kglnsk/amp-power-whitepaper/media/results/photo_electronics.png

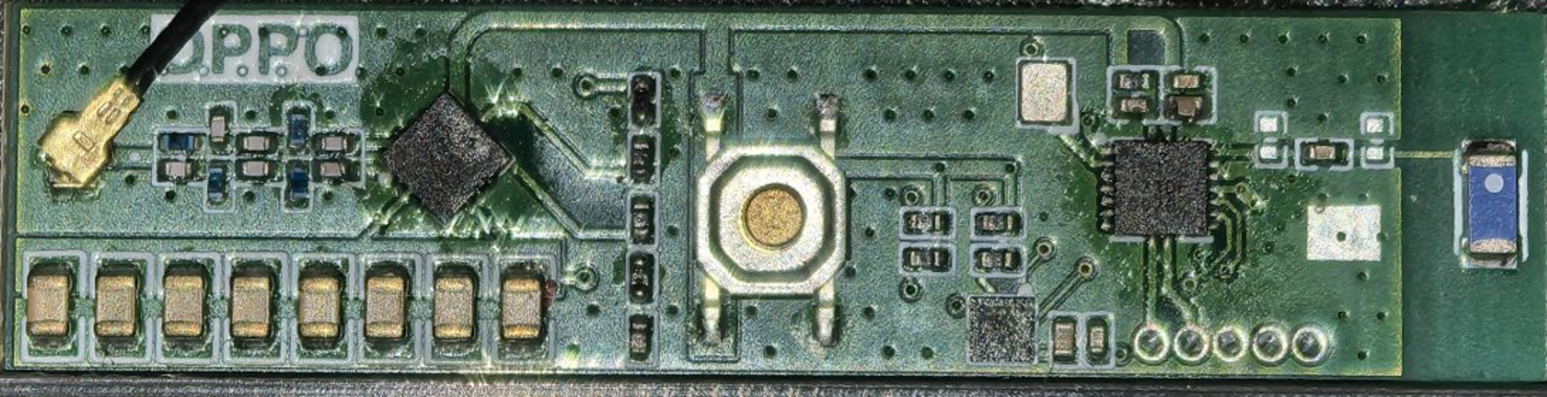
media/results/photo_electronics.png
