kglnsk/amp-power-whitepaper/media/sources/antenna_component_dimensions.png

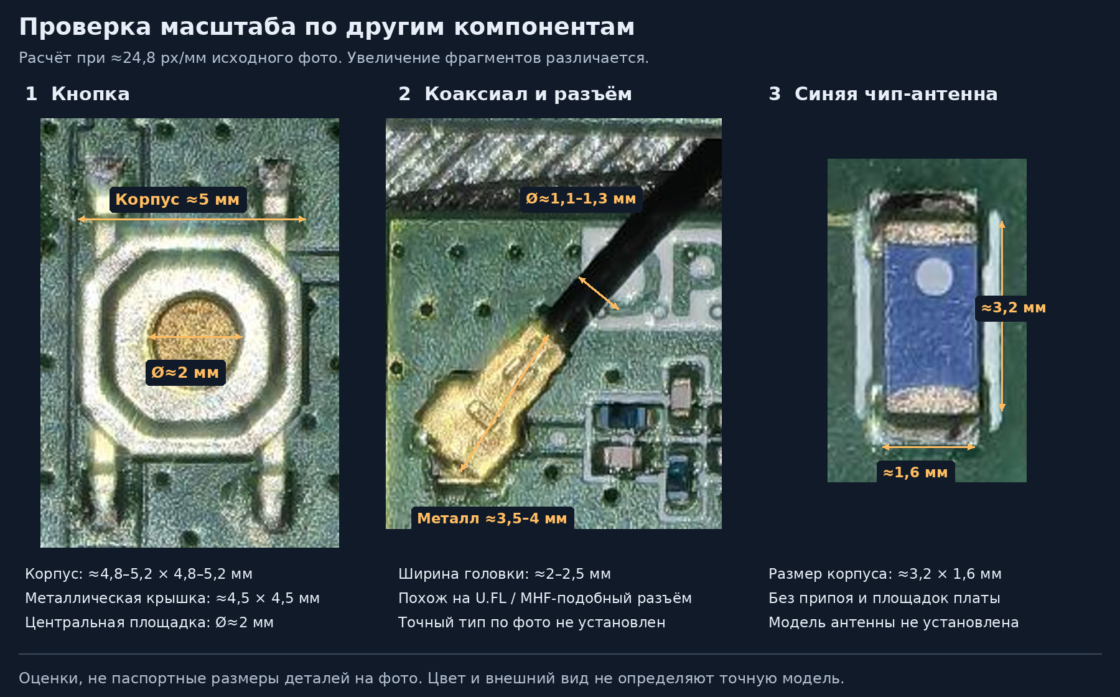
media/sources/antenna_component_dimensions.png
