kglnsk/amp-power-whitepaper/media/results/electronics_868_poster.png

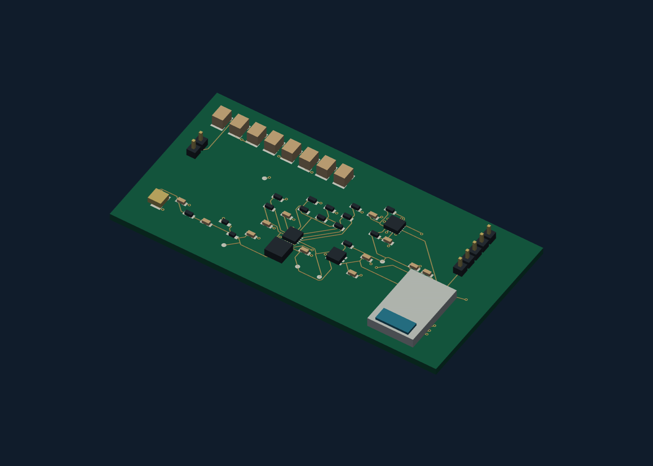
media/results/electronics_868_poster.png
