kglnsk/amp-power-whitepaper/downloads/results/budget.csv

scenario | band_MHz | eirp_dBm | distance_m | rf_duty | receive_gain_dBi | other_losses_dB | rf_on_dBm | pdc_on_model_uW | storage_average_uW | net_idle_uW | cold_start_power_only | feature_cycle_s | raw_cycle_s | raw_paced_cycle_s | clamped_above_simulation
WiFi idle | 2450 | 20 | 0.5 | 0.02 | 3 | 6 | -17.210504995894397 | 4.112073038303948 | 0.04029831577537869 | -2.4597016842246213 | False |  |  |  | False
WiFi idle | 2450 | 20 | 1 | 0.02 | 3 | 6 | -23.23110490917403 | 0.23232196889256107 | 0.0022767552951470987 | -2.4977232447048534 | False |  |  |  | False
WiFi idle | 2450 | 20 | 3 | 0.02 | 3 | 6 | -32.773530003567274 | 0.0 | 0.0 | -2.5 | False |  |  |  | False
WiFi idle | 2450 | 20 | 5 | 0.02 | 3 | 6 | -37.210504995894404 | 0.0 | 0.0 | -2.5 | False |  |  |  | False
WiFi busy | 2450 | 20 | 0.5 | 0.5 | 3 | 6 | -17.210504995894397 | 4.112073038303948 | 1.0074578943844672 | -1.492542105615533 | False |  |  |  | False
WiFi busy | 2450 | 20 | 1 | 0.5 | 3 | 6 | -23.23110490917403 | 0.23232196889256107 | 0.056918882378677454 | -2.4430811176213227 | False |  |  |  | False
WiFi busy | 2450 | 20 | 3 | 0.5 | 3 | 6 | -32.773530003567274 | 0.0 | 0.0 | -2.5 | False |  |  |  | False
WiFi busy | 2450 | 20 | 5 | 0.5 | 3 | 6 | -37.210504995894404 | 0.0 | 0.0 | -2.5 | False |  |  |  | False
WPT 2.45GHz 1W EIRP | 2450 | 30 | 0.5 | 0.9 | 3 | 6 | -7.2105049958943965 | 74.47782285282939 | 32.844719878097756 | 30.34471987809776 | True | 30.318289432094524 | 197.72797455713823 | 281.0999645002004 | False
WPT 2.45GHz 1W EIRP | 2450 | 30 | 1 | 0.9 | 3 | 6 | -13.231104909174029 | 13.448290278307708 | 5.930696012733699 | 3.4306960127336983 | False | 268.1671580883996 | 1748.9162484026065 |  | False
WPT 2.45GHz 1W EIRP | 2450 | 30 | 3 | 0.9 | 3 | 6 | -22.773530003567274 | 0.29241863801540374 | 0.12895661936479302 | -2.371043380635207 | False |  |  |  | False
WPT 2.45GHz 1W EIRP | 2450 | 30 | 5 | 0.9 | 3 | 6 | -27.210504995894404 | 0.0 | 0.0 | -2.5 | False |  |  |  | False
WPT 2.45GHz 4W EIRP | 2450 | 36 | 0.5 | 0.9 | 3 | 6 | -1.2105049958943965 | 133.57811999999998 | 58.90795091999999 | 56.40795091999999 | True | 20 | 106.36798362892918 | 126.56104901316839 | True
WPT 2.45GHz 4W EIRP | 2450 | 36 | 1 | 0.9 | 3 | 6 | -7.231104909174029 | 74.06924994081689 | 32.66453922390024 | 30.164539223900242 | True | 30.499388476355612 | 198.9090552805801 | 283.4930605635131 | False
WPT 2.45GHz 4W EIRP | 2450 | 36 | 3 | 0.9 | 3 | 6 | -16.773530003567274 | 4.653360054478848 | 2.052131784025172 | -0.4478682159748282 | False |  |  |  | False
WPT 2.45GHz 4W EIRP | 2450 | 36 | 5 | 0.9 | 3 | 6 | -21.210504995894404 | 0.497702178624538 | 0.21948666077342124 | -2.280513339226579 | False |  |  |  | False
WPT 915MHz FR4 | 915 | 30 | 0.5 | 0.9 | -1 | 6 | -2.6556051899327144 | 95.8626 | 42.27540659999999 | 39.77540659999999 | True | 23.12987040590052 | 150.84698090804687 | 194.96086852675415 | True
WPT 915MHz FR4 | 915 | 30 | 1 | 0.9 | -1 | 6 | -8.67620510321234 | 36.54908170906976 | 16.11814503369976 | 13.618145033699761 | False | 67.55692480314666 | 440.5886400205217 | 1299.2229469227354 | False
WPT 915MHz FR4 | 915 | 30 | 3 | 0.9 | -1 | 6 | -18.21863019760559 | 2.525552006077879 | 1.1137684346803445 | -1.3862315653196555 | False |  |  |  | False
WPT 915MHz FR4 | 915 | 30 | 5 | 0.9 | -1 | 6 | -22.655605189932714 | 0.38156455614679213 | 0.1682699692607353 | -2.3317300307392648 | False |  |  |  | False
