kglnsk/amp-power-whitepaper/media/results/assembly_3d.png

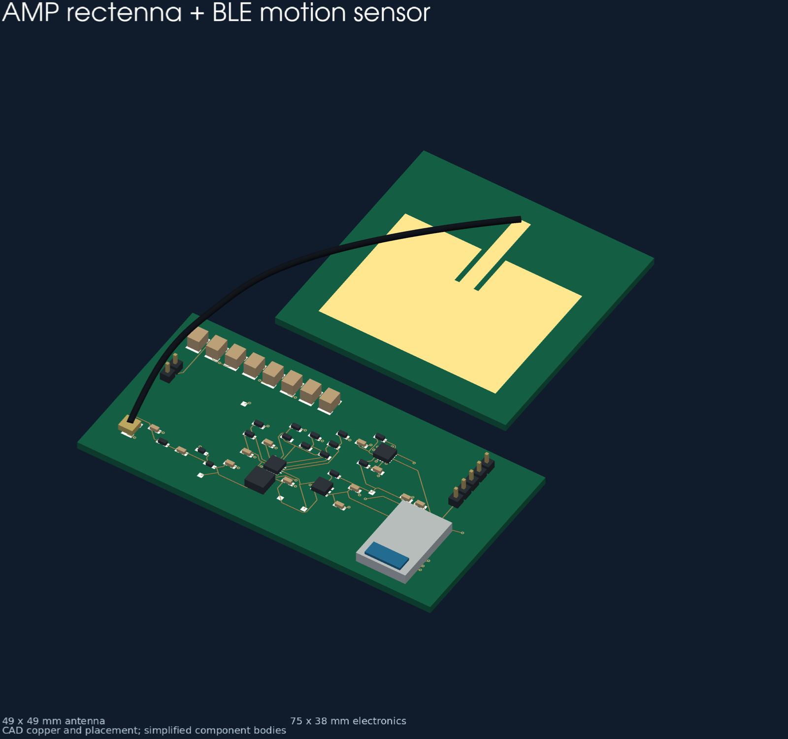
media/results/assembly_3d.png
