kglnsk/amp-power-whitepaper/media/results/assembly_868_poster.png

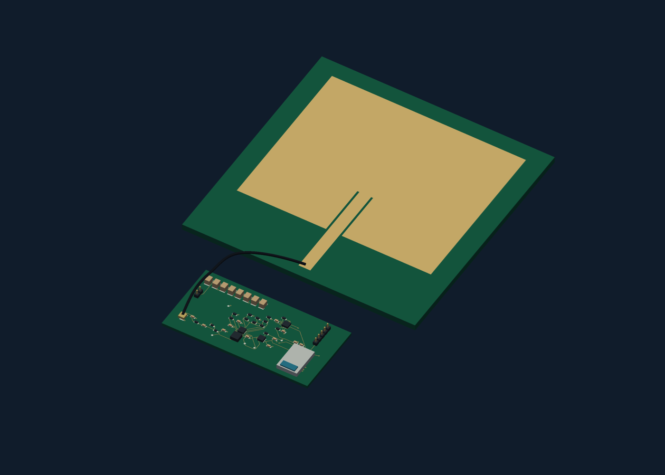
media/results/assembly_868_poster.png
