kglnsk/amp-power-whitepaper/media/results/assembly_top.png

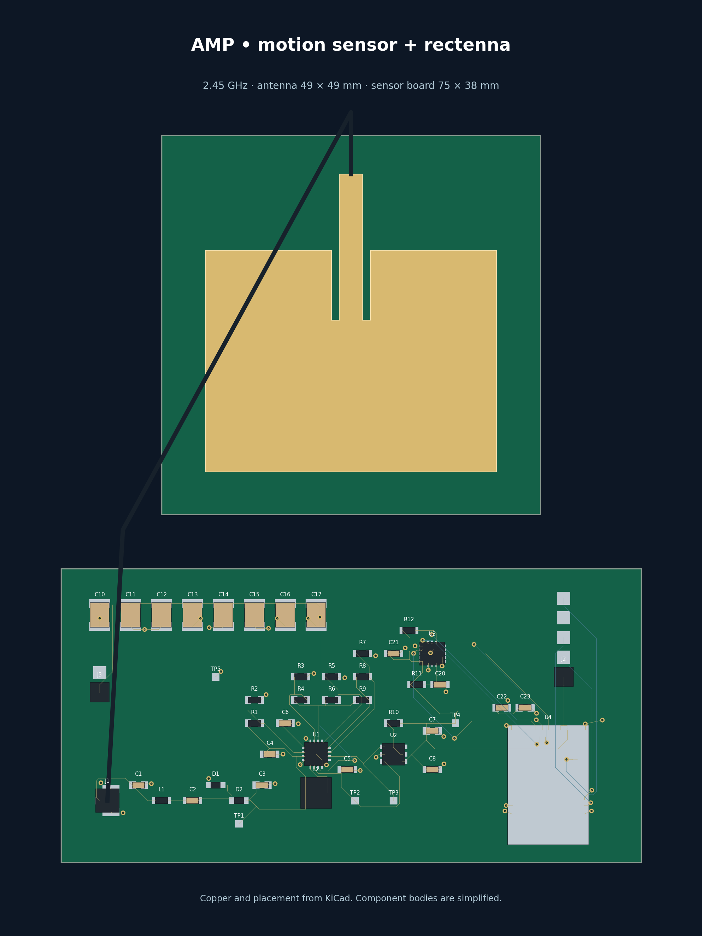
media/results/assembly_top.png
