kglnsk/amp-power-whitepaper/downloads/results/budget_868.csv

antenna_case | gain_dBi | extra_polarization_loss_dB | other_loss_dB | eirp_dBm | duty | distance_m | rf_on_dBm | stored_uW | net_uW | feature_cycle_s | cold_power_screen | curve_clamped
Taoglas reference 70mm ground | 2.17 | 0 | 6 | 20 | 0.9 | 0.5 | -9.027577812133586 | 12.7729226552175 | 10.2729226552175 | 89.55581881391296 | False | False
Taoglas reference 70mm ground | 2.17 | 0 | 6 | 20 | 0.9 | 1 | -15.048177725413211 | 2.1208913112400527 | -0.37910868875994747 |  | False | False
Taoglas reference 70mm ground | 2.17 | 0 | 6 | 20 | 0.9 | 3 | -24.590602819806456 | 0.014532594227435958 | -2.4854674057725643 |  | False | False
Taoglas reference 70mm ground | 2.17 | 0 | 6 | 30 | 0.9 | 0.5 | 0.9724221878664139 | 39.79999421999999 | 37.299994219999995 | 24.664883178633378 | True | True
Taoglas reference 70mm ground | 2.17 | 0 | 6 | 30 | 0.9 | 1 | -5.048177725413211 | 39.26879357934815 | 36.76879357934815 | 25.02121800691156 | True | False
Taoglas reference 70mm ground | 2.17 | 0 | 6 | 30 | 0.9 | 3 | -14.590602819806456 | 2.598120914794909 | 0.09812091479490888 | 9376.186533961414 | False | False
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
