kglnsk/amp-power-whitepaper/downloads/results/budget_fr4_868.csv

mode | gain_dBi | distance_m | eirp_dBm | duty | other_loss_dB | rf_on_dBm | stored_uW | net_uW | feature_cycle_s | raw_paced_cycle_s | cold_power_screen | curve_clamped
free | 1.6083529268196894 | 0.5 | 20 | 0.02 | 6 | -9.589224885313897 | 0.23181377307584564 | -2.2681862269241546 |  |  | False | False
free | 1.6083529268196894 | 0.5 | 20 | 0.5 | 6 | -9.589224885313897 | 5.79534432689614 | 3.2953443268961404 | 279.1817512030802 |  | False | False
free | 1.6083529268196894 | 0.5 | 20 | 0.9 | 6 | -9.589224885313897 | 10.431619788413053 | 7.9316197884130535 | 115.99143990033241 |  | False | False
free | 1.6083529268196894 | 1 | 20 | 0.02 | 6 | -15.609824798593522 | 0.04223257789333621 | -2.457767422106664 |  |  | False | False
free | 1.6083529268196894 | 1 | 20 | 0.5 | 6 | -15.609824798593522 | 1.0558144473334055 | -1.4441855526665948 |  |  | False | False
free | 1.6083529268196894 | 1 | 20 | 0.9 | 6 | -15.609824798593522 | 1.9004660052001299 | -0.5995339947998704 |  |  | False | False
free | 1.6083529268196894 | 3 | 20 | 0.02 | 6 | -25.152249892986767 | 0.0 | -2.5 |  |  | False | False
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
