kglnsk/amp-power-whitepaper/media/results/antenna_868_pattern.png

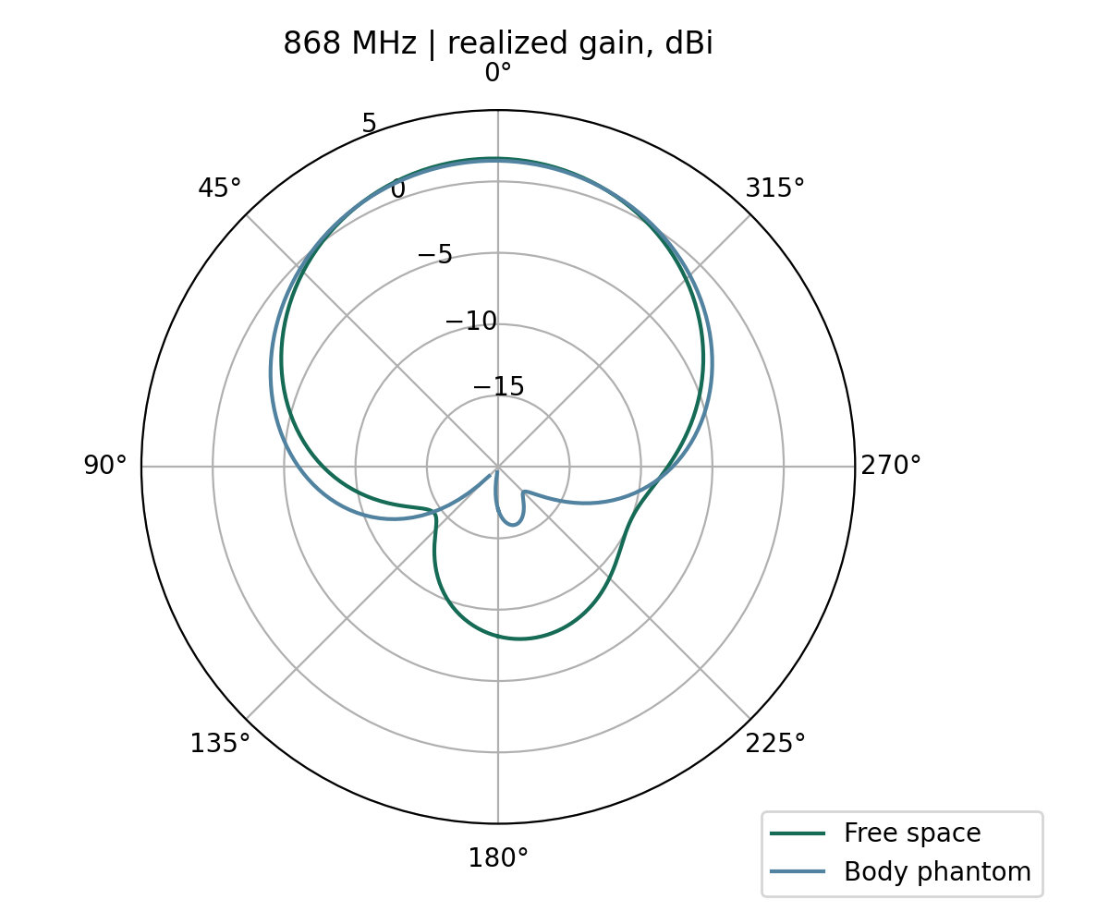
media/results/antenna_868_pattern.png
