kglnsk/amp-power-whitepaper/media/results/antenna_comparison.png

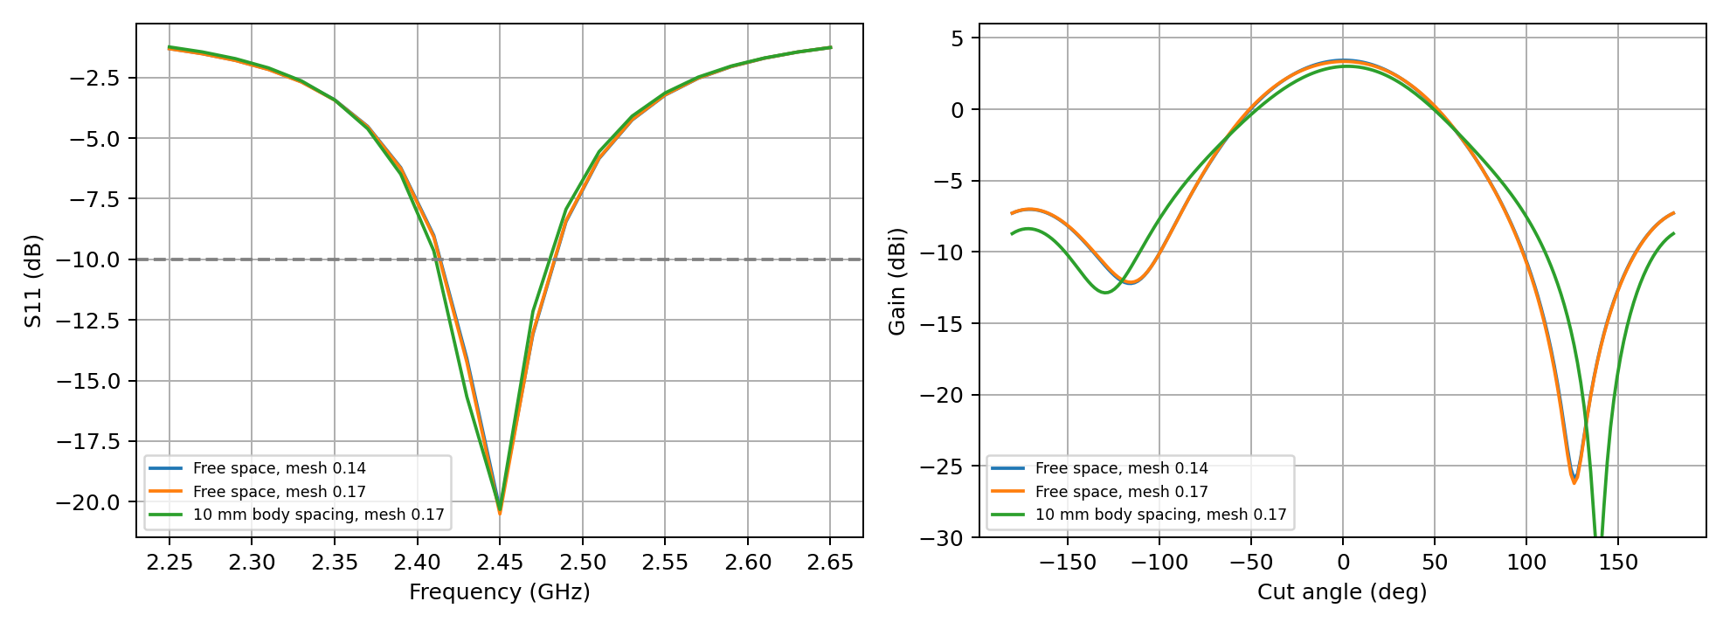
media/results/antenna_comparison.png
