kglnsk/amp-power-whitepaper/media/results/compact.png

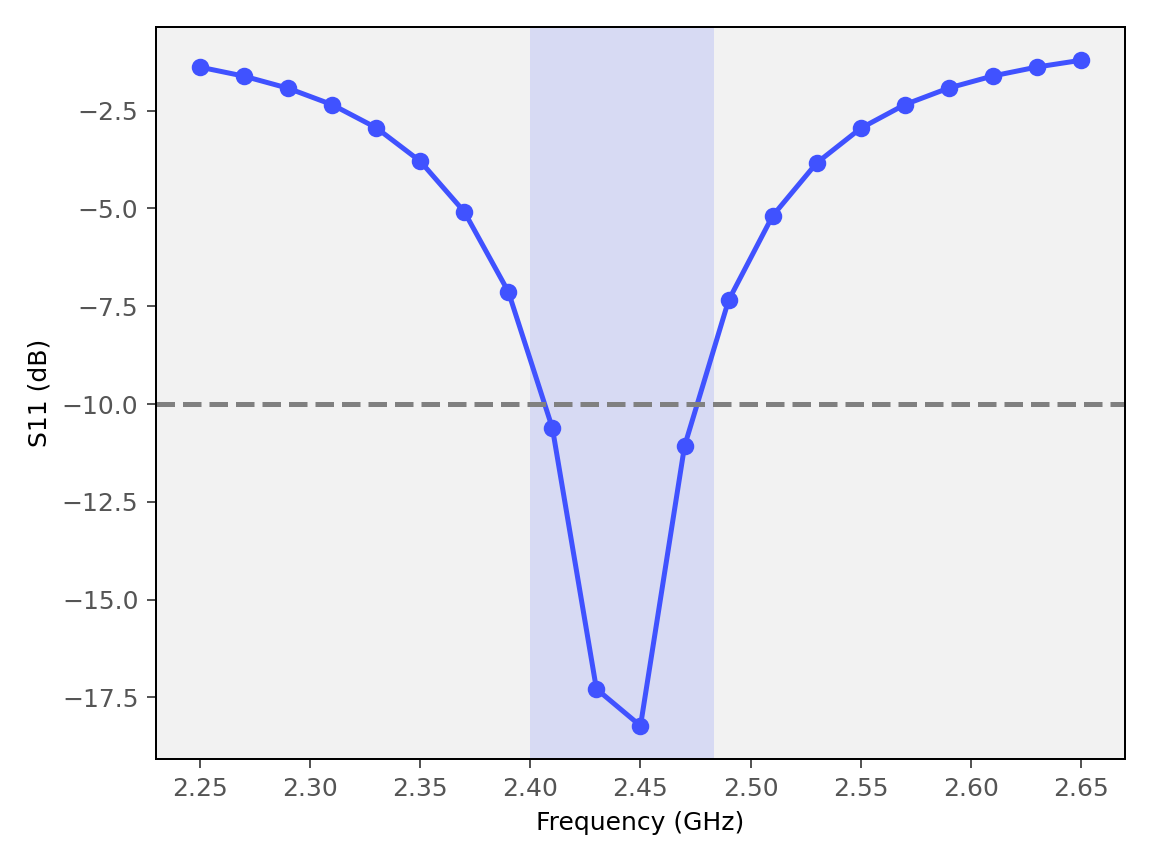
media/results/compact.png
