kglnsk/amp-power-whitepaper/media/results/energy_budget.png

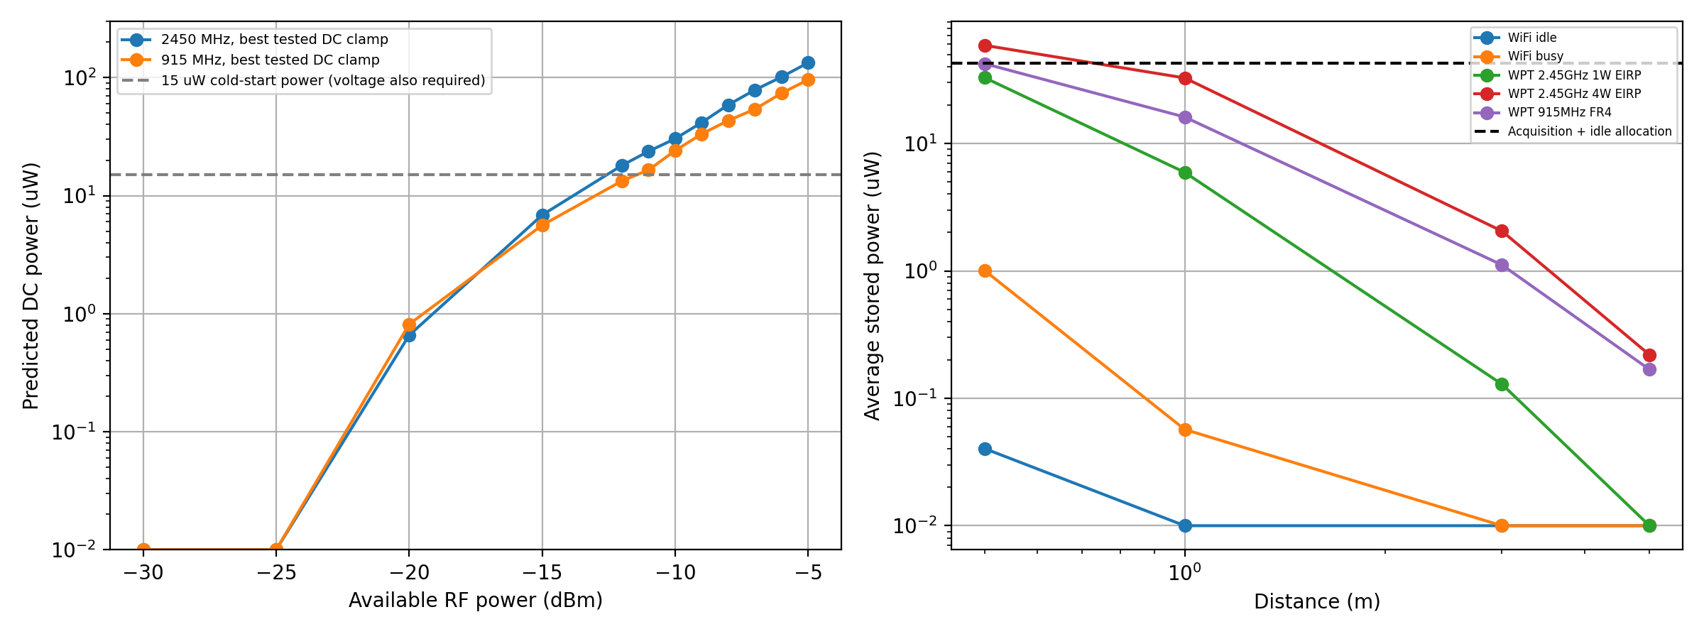
media/results/energy_budget.png
