kglnsk/amp-power-whitepaper/media/results/fr4_868_body.png

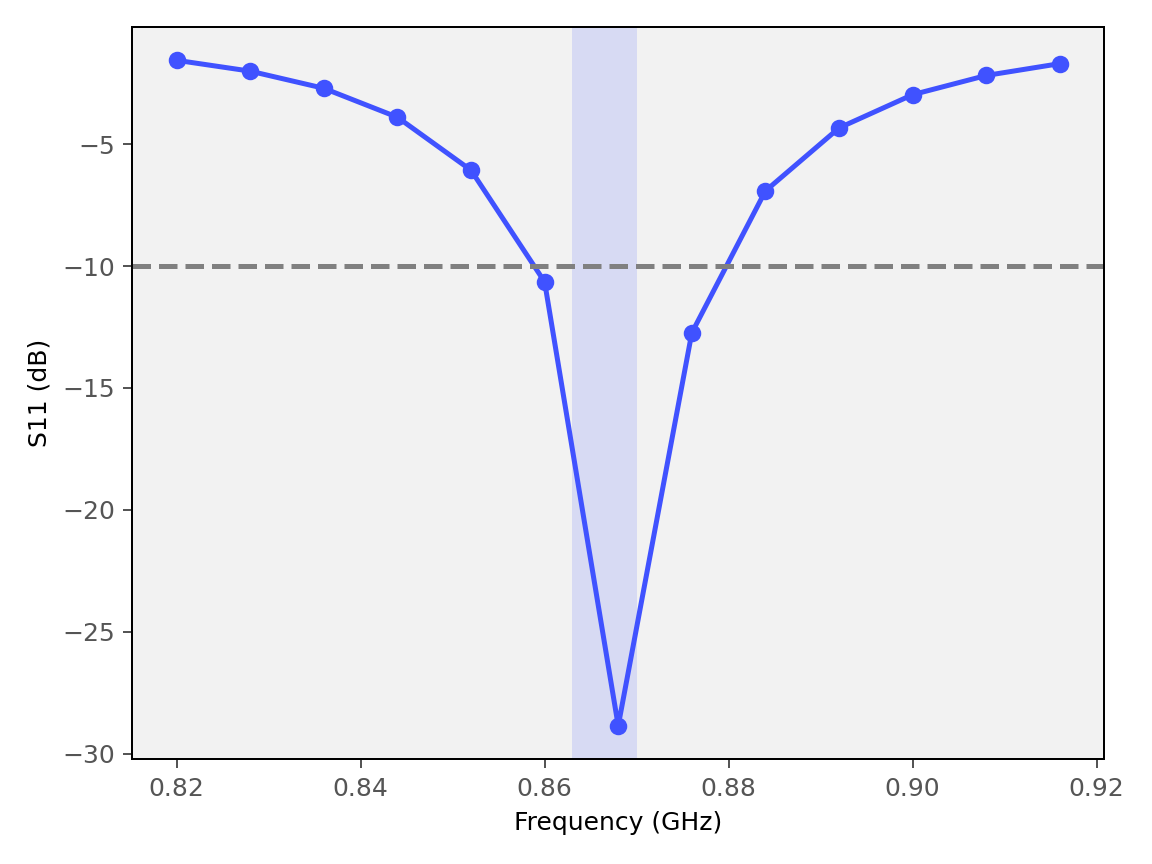
media/results/fr4_868_body.png
