kglnsk/amp-power-whitepaper/media/results/fr4_868_final.png

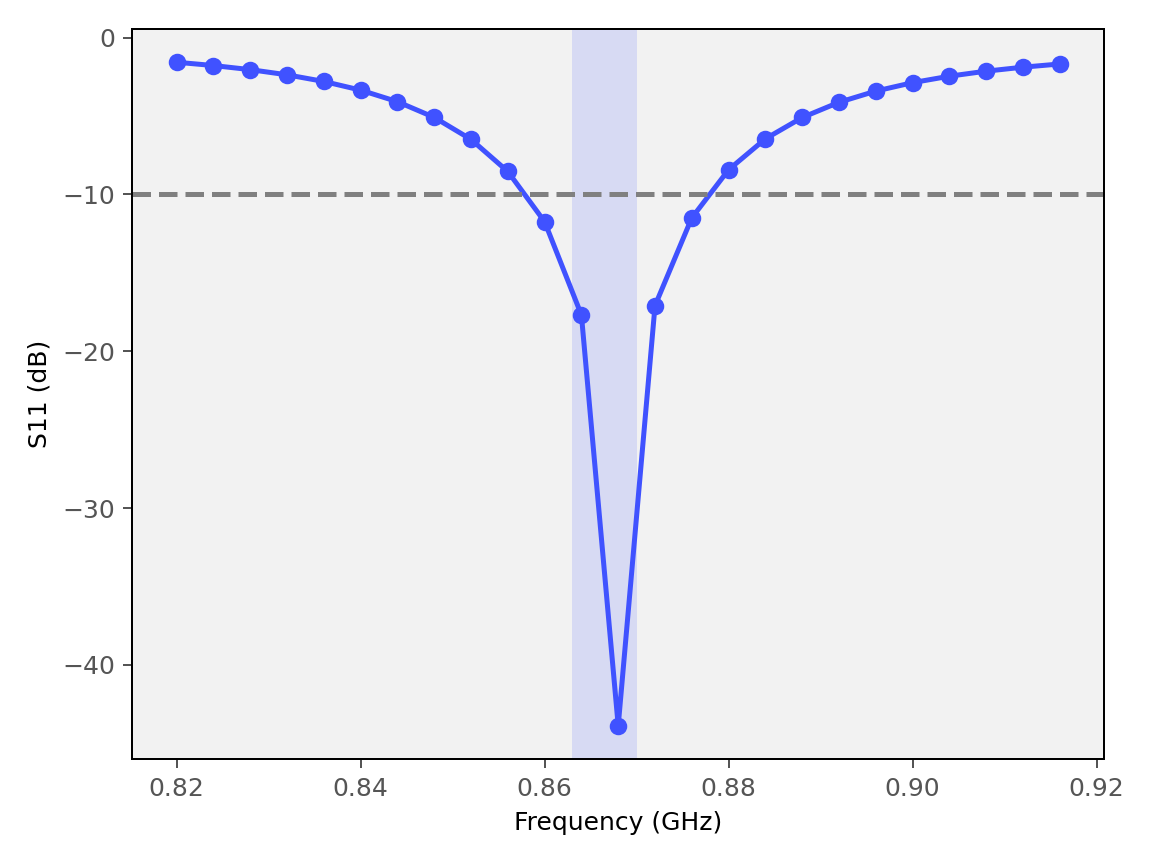
media/results/fr4_868_final.png
