kglnsk/amp-power-whitepaper/media/results/fr4_868_initial.png

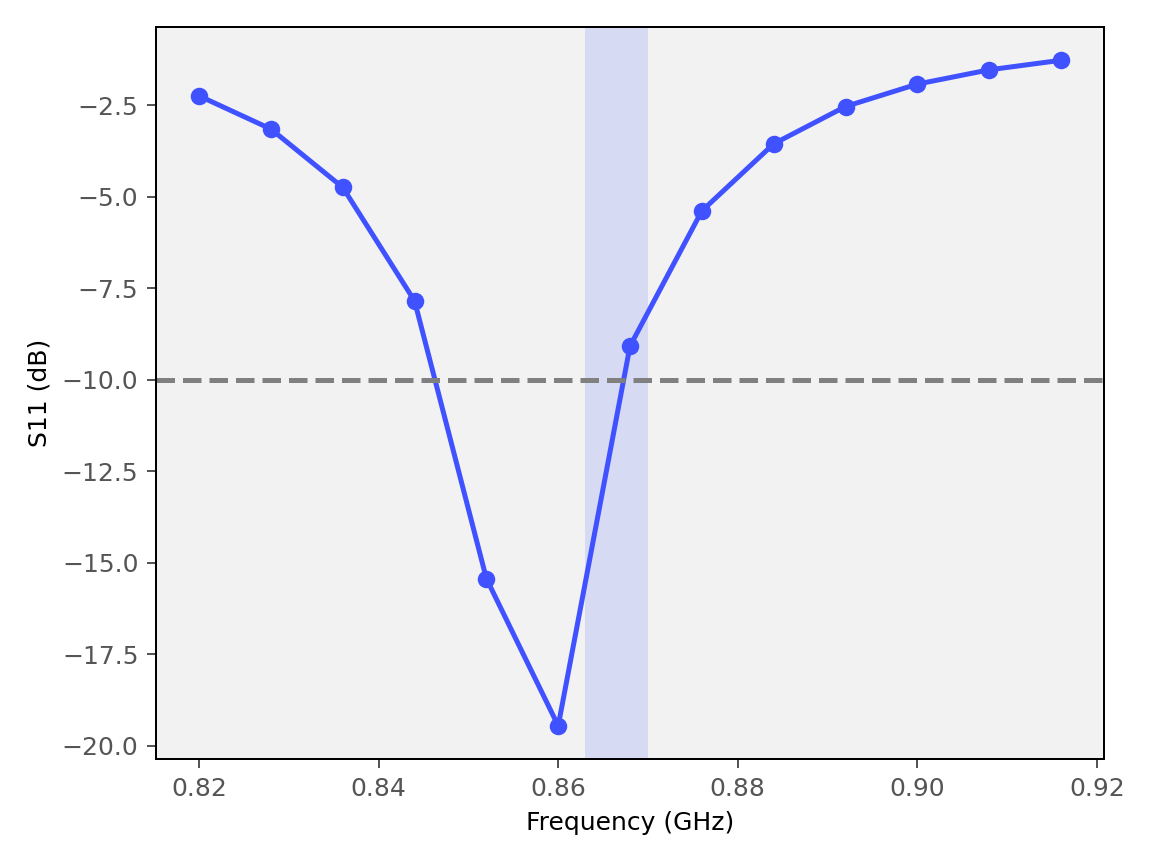
media/results/fr4_868_initial.png
