kglnsk/amp-power-whitepaper/media/results/initial.png

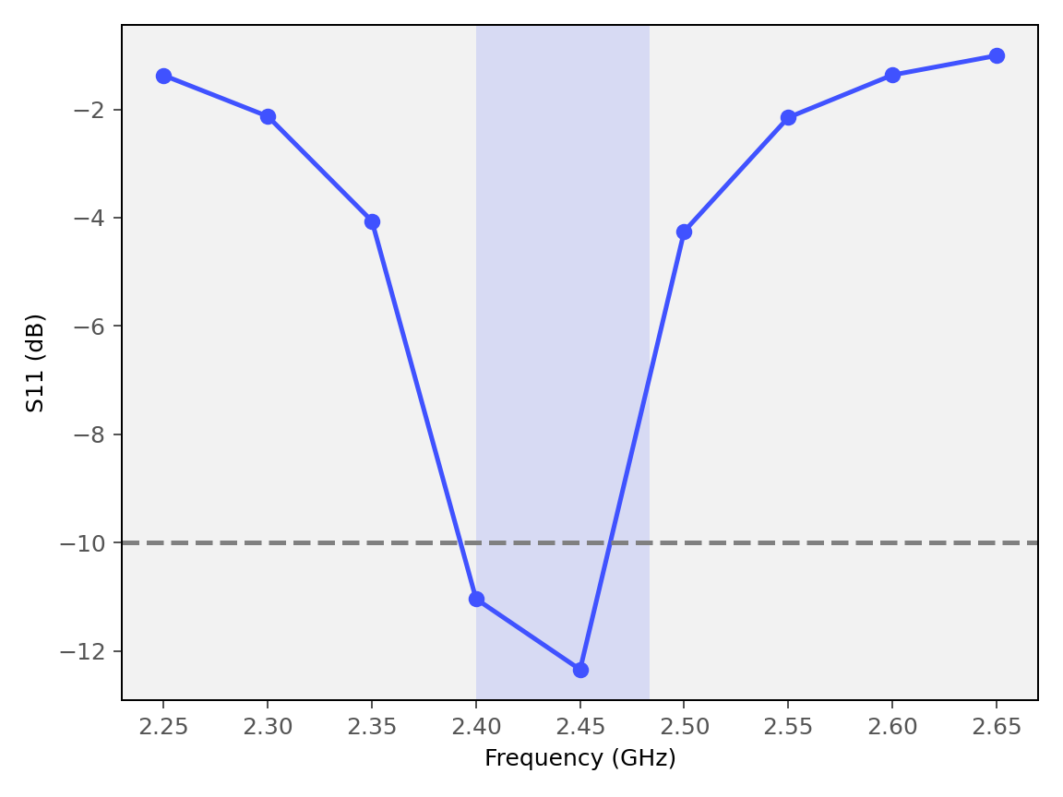
media/results/initial.png
