kglnsk/amp-power-whitepaper/media/results/pcb_combined.png

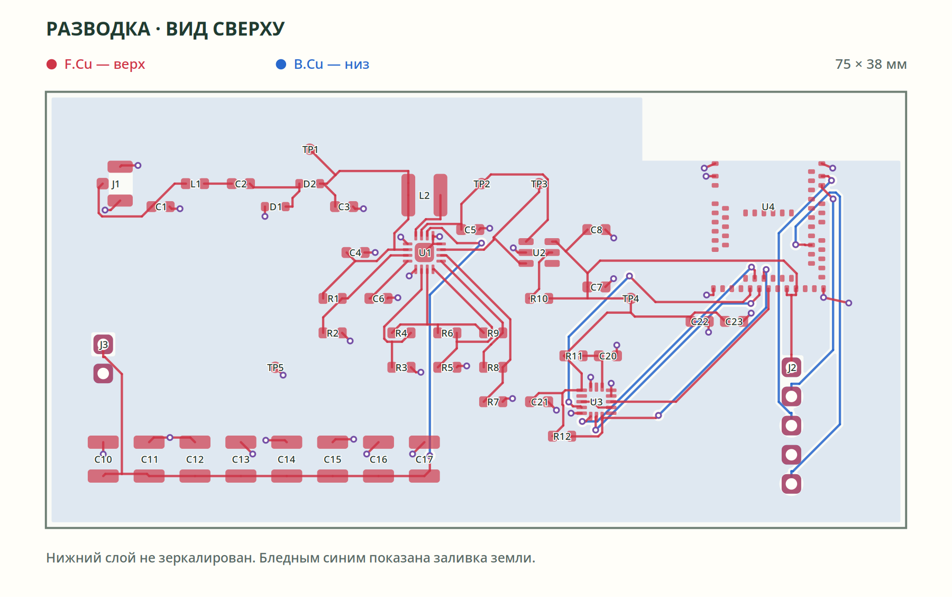
media/results/pcb_combined.png
