kglnsk/amp-power-whitepaper/media/results/uhf_initial.png

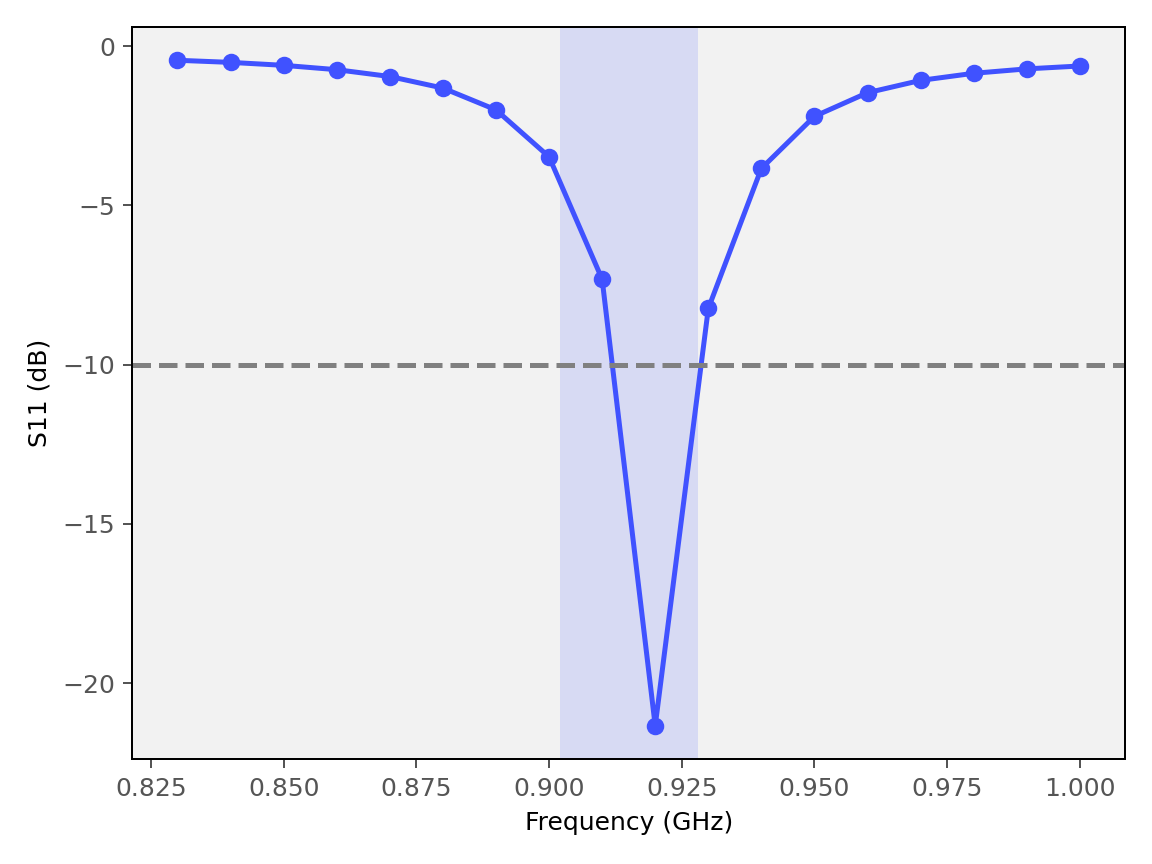
media/results/uhf_initial.png
