kglnsk/amp-power-whitepaper/downloads/hardware/amp_sensor.pdf

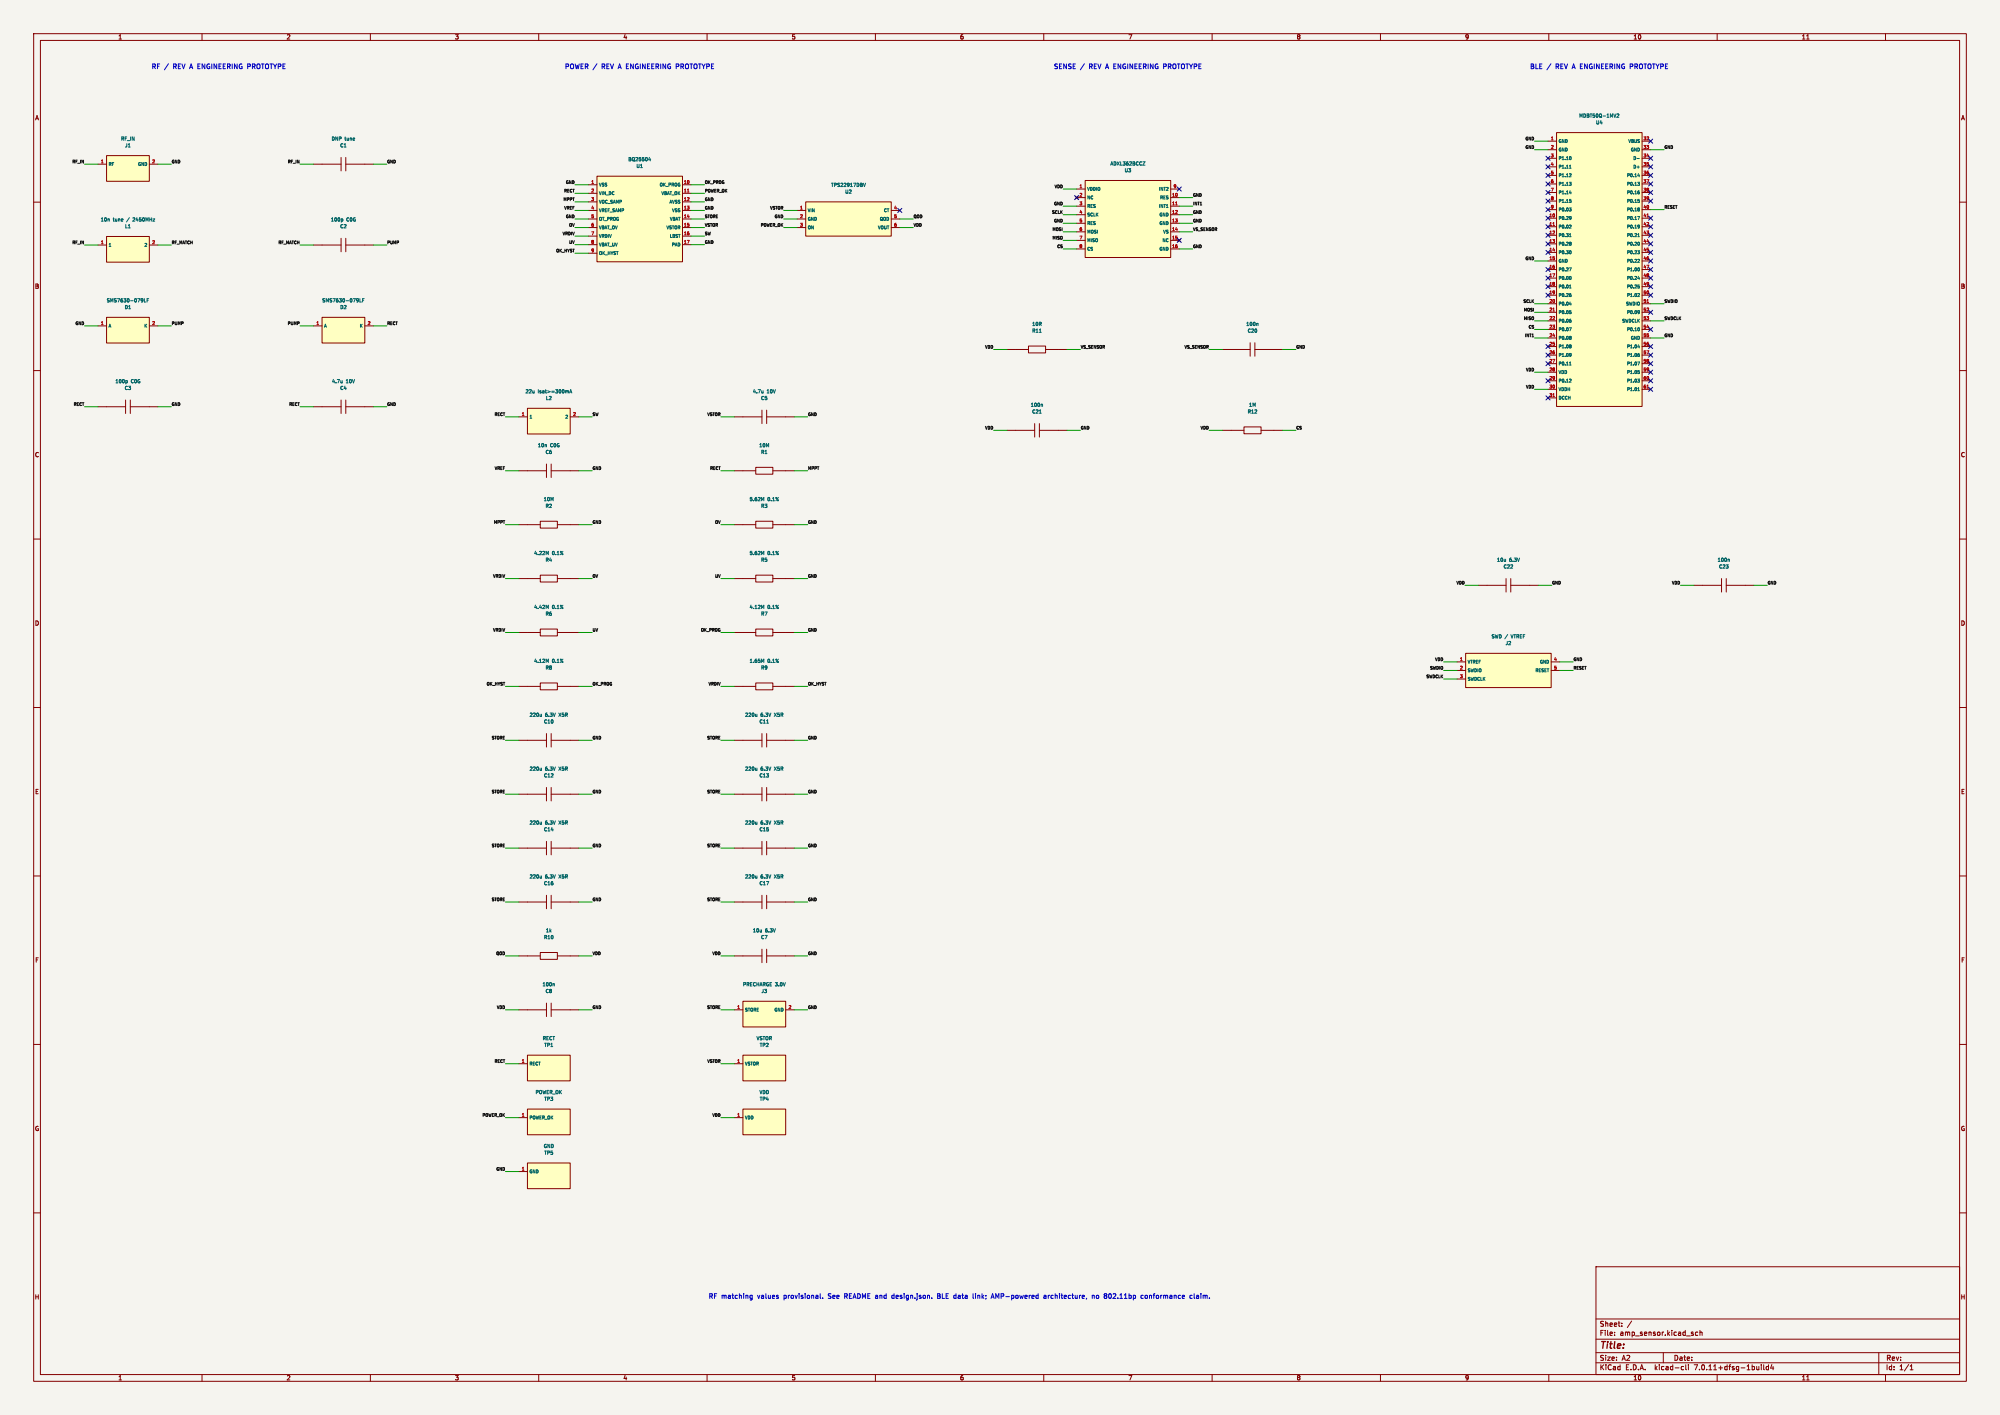
[picture p27: page 1]

POWER / REV A ENGINEERING PROTOTYPE
