kglnsk/amp-power-whitepaper/downloads/hardware/868/amp_sensor.pdf

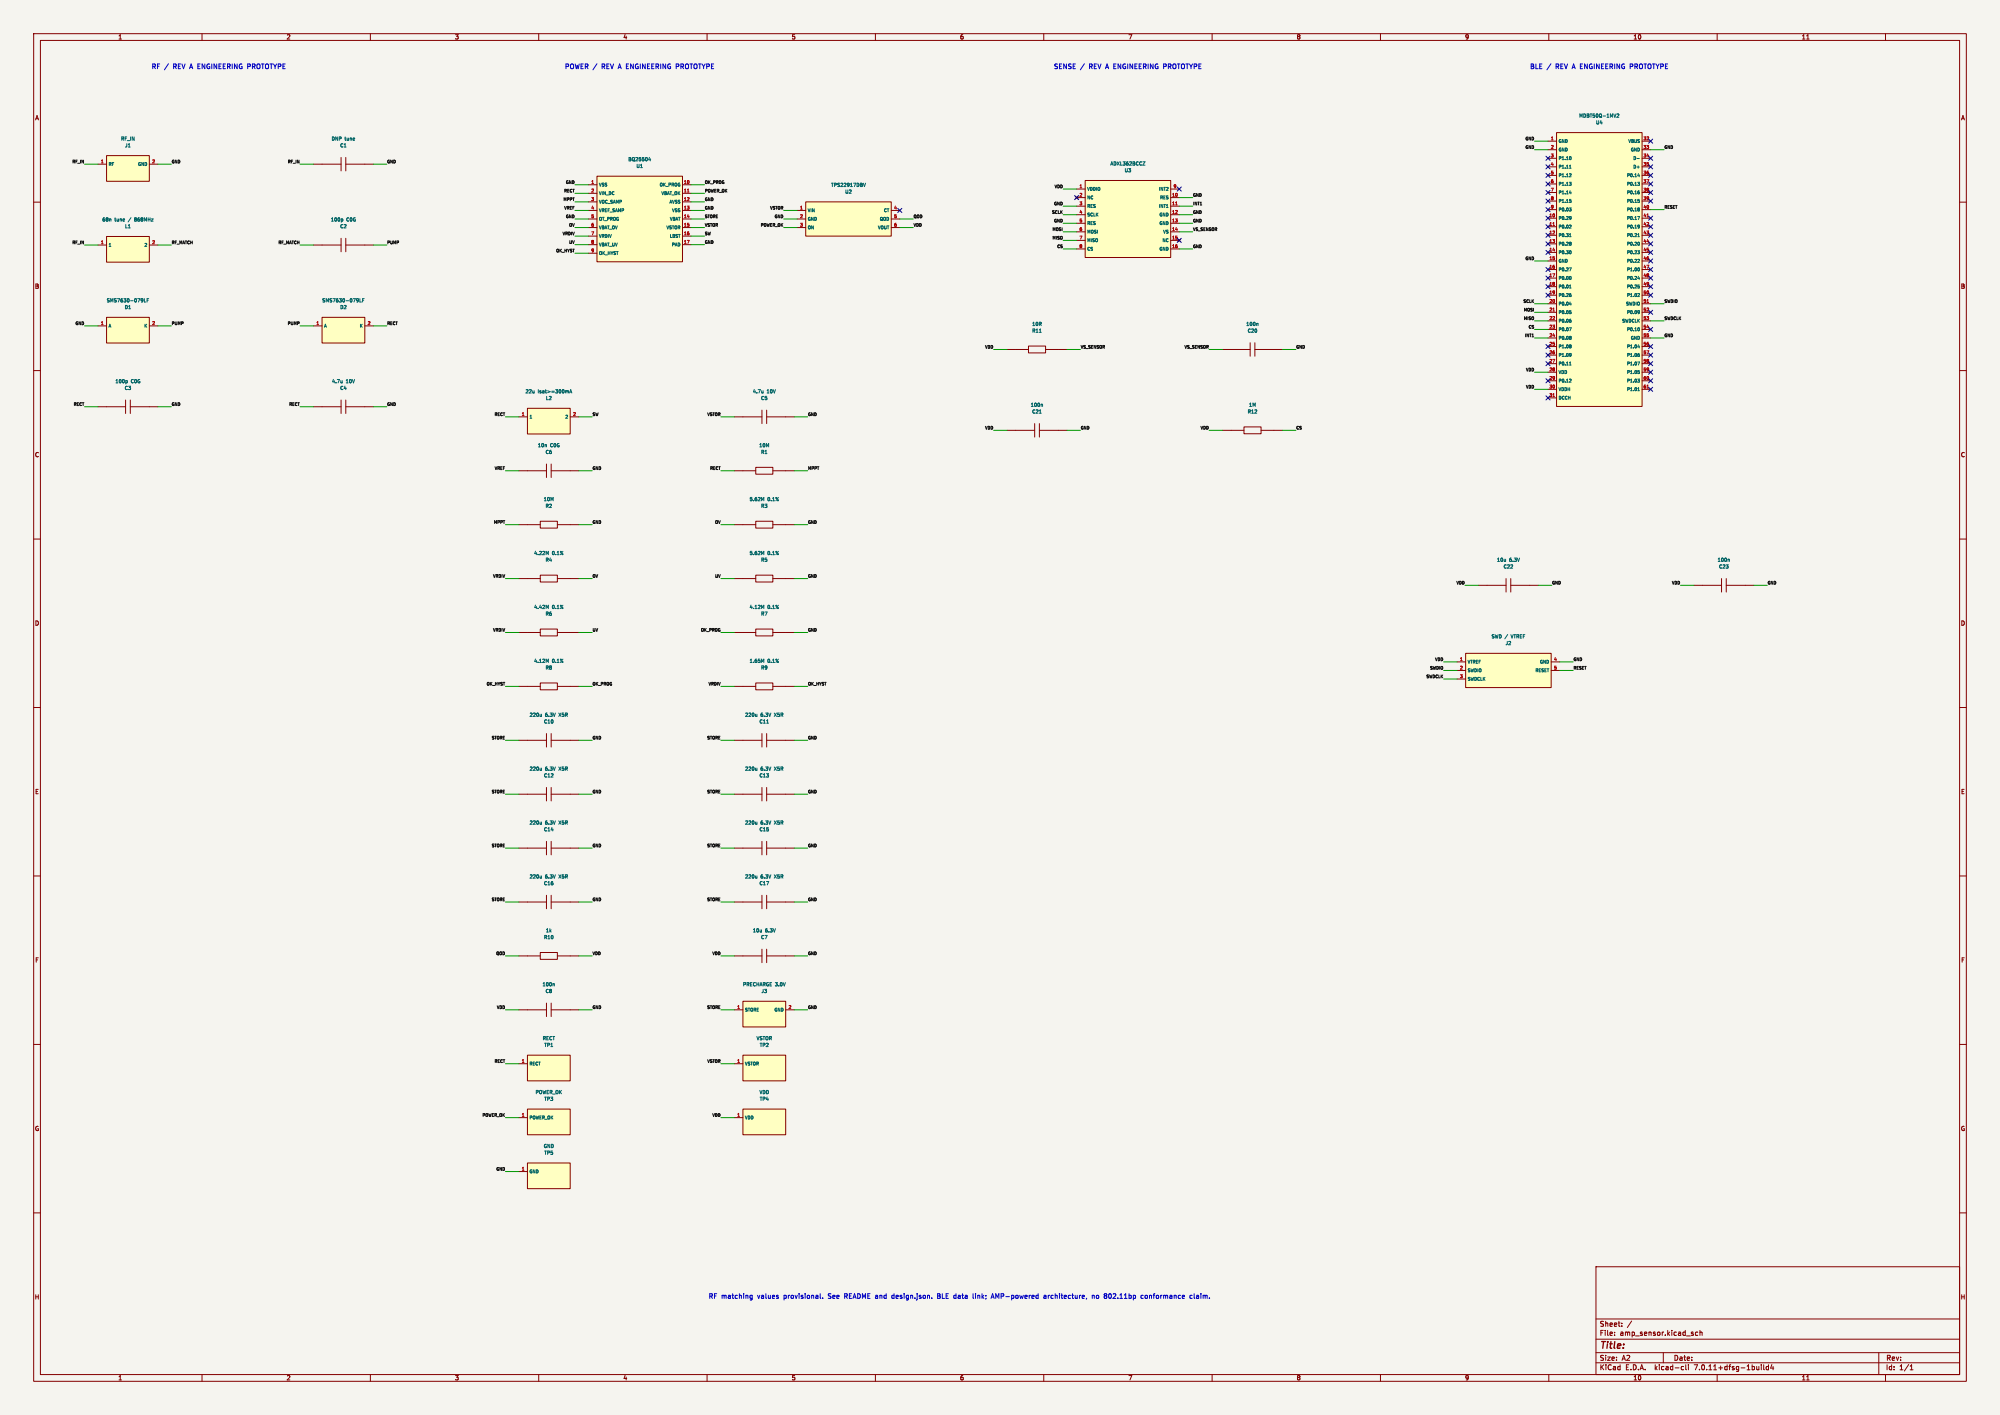
[picture p28: page 1]

POWER / REV A ENGINEERING PROTOTYPE
