kglnsk/amp-power-whitepaper/downloads/hardware/amp_sensor.kicad_pcb

## KiCad design downloads/hardware/amp_sensor.kicad_pcb (2026-11-11)

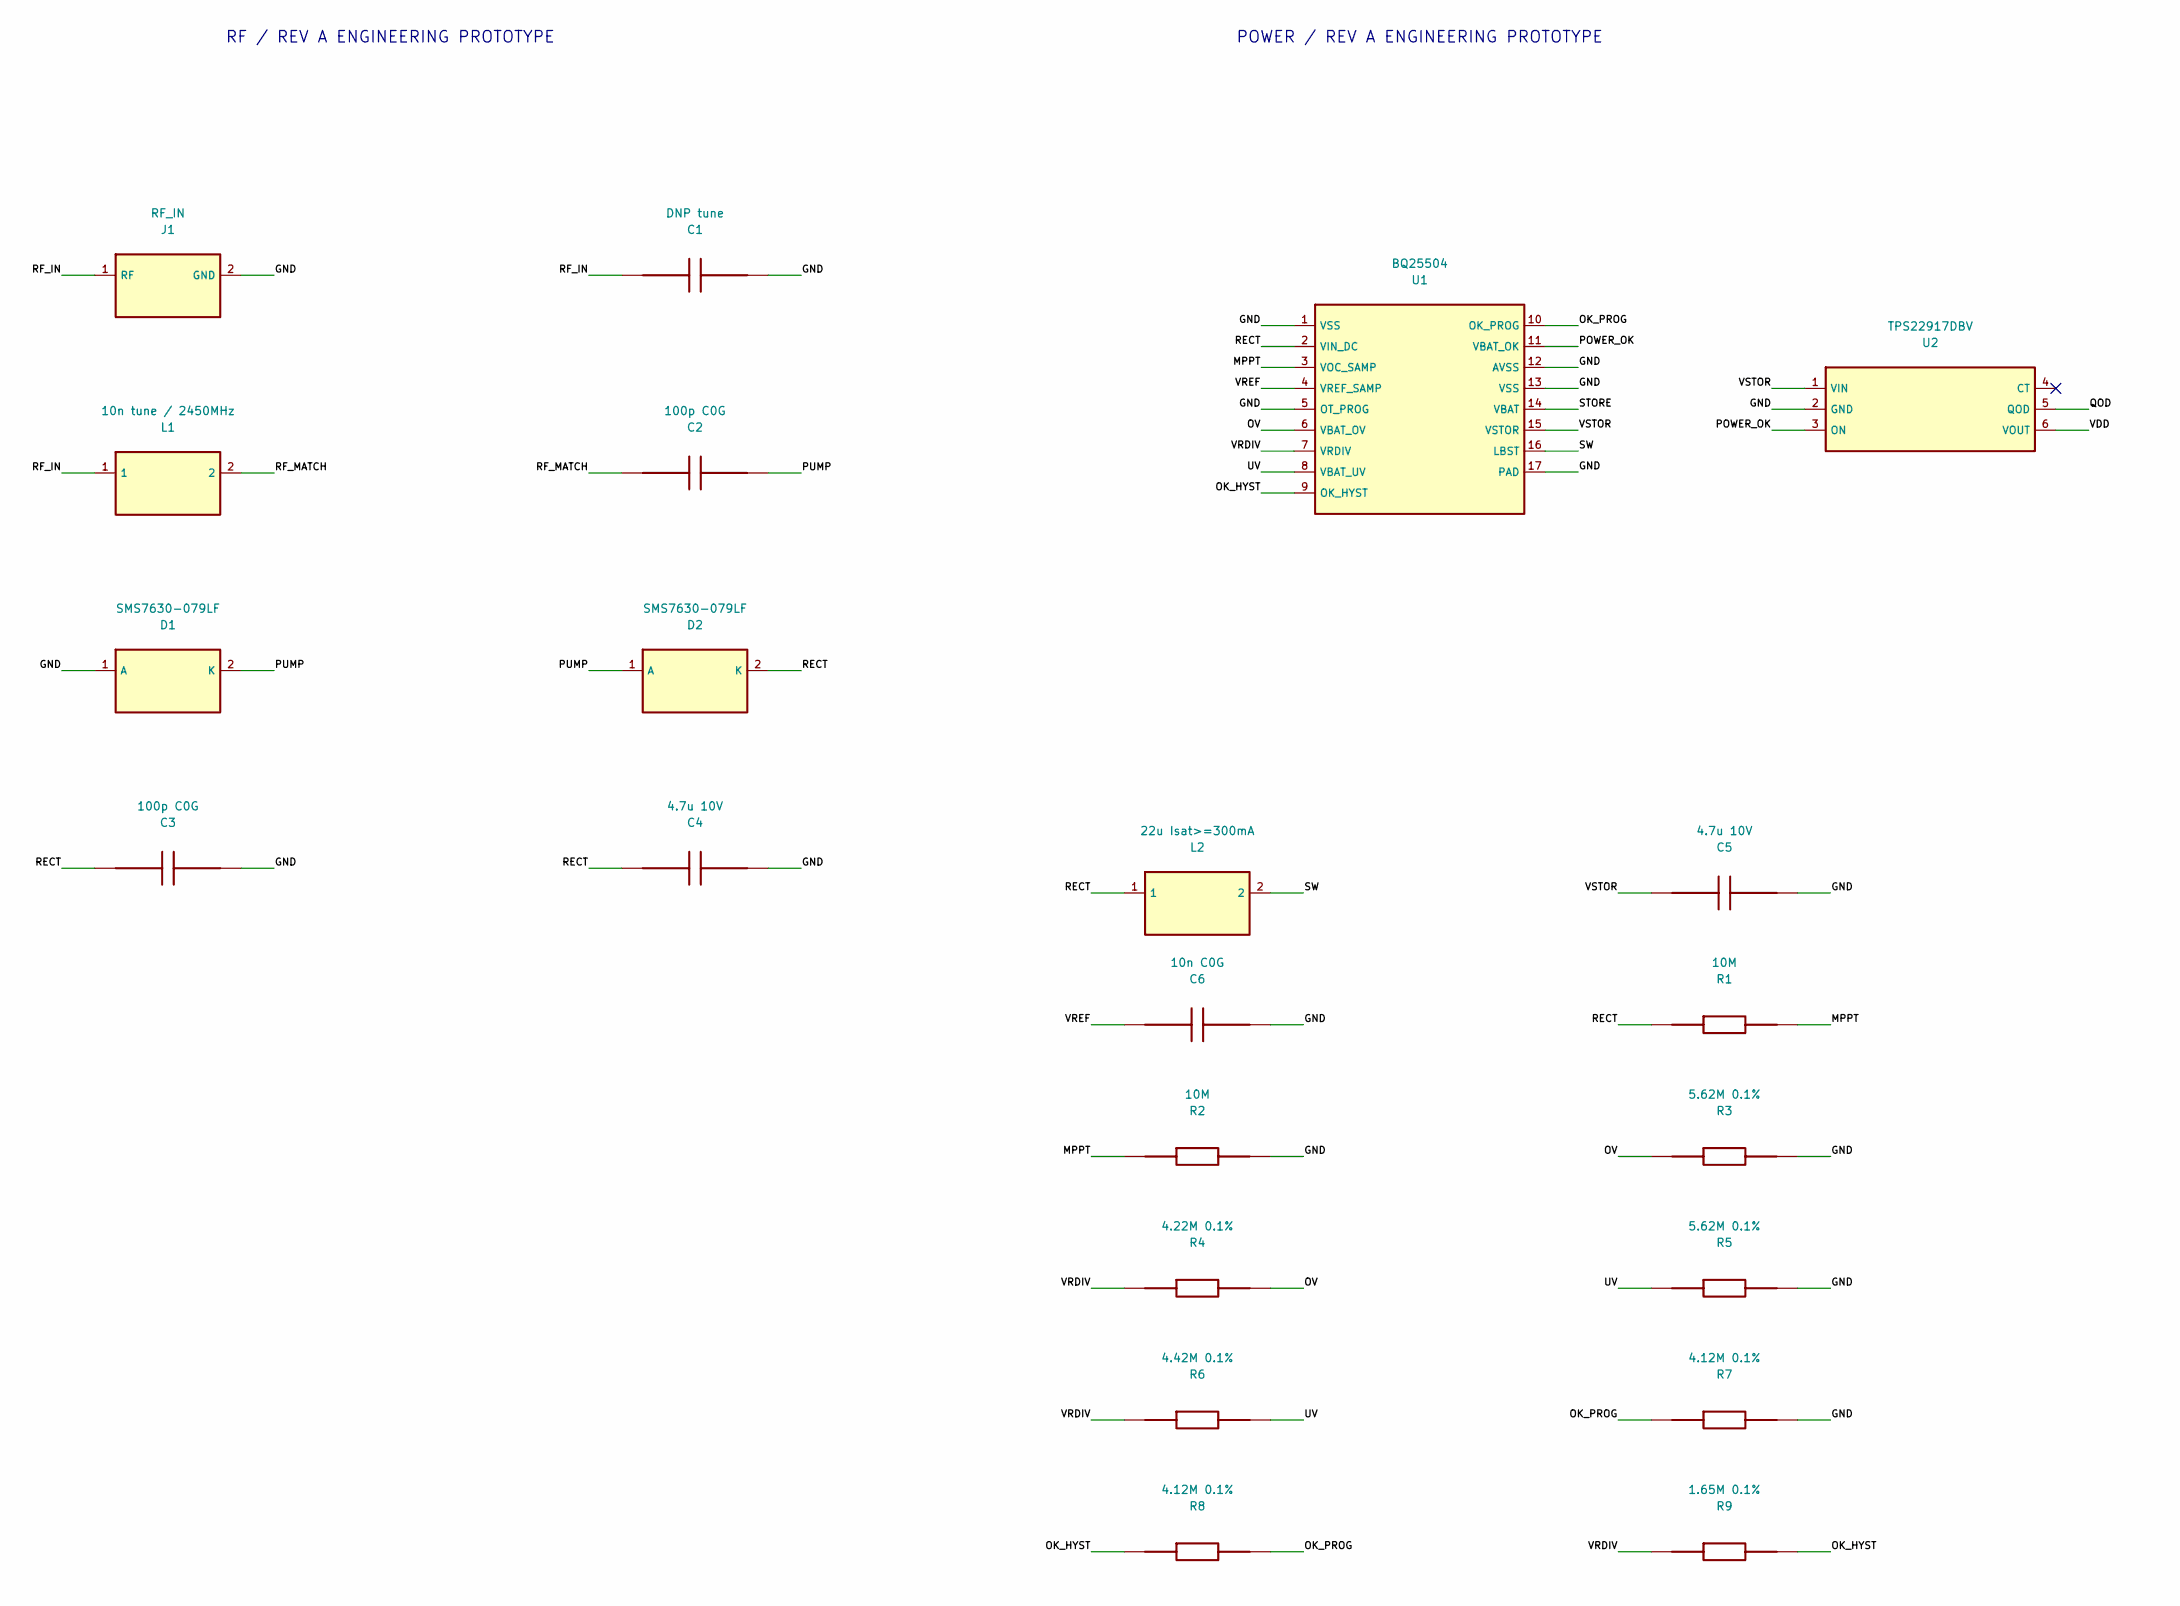
[picture p29: schematic amp_sensor.kicad_sch, part in row 1, column 1]

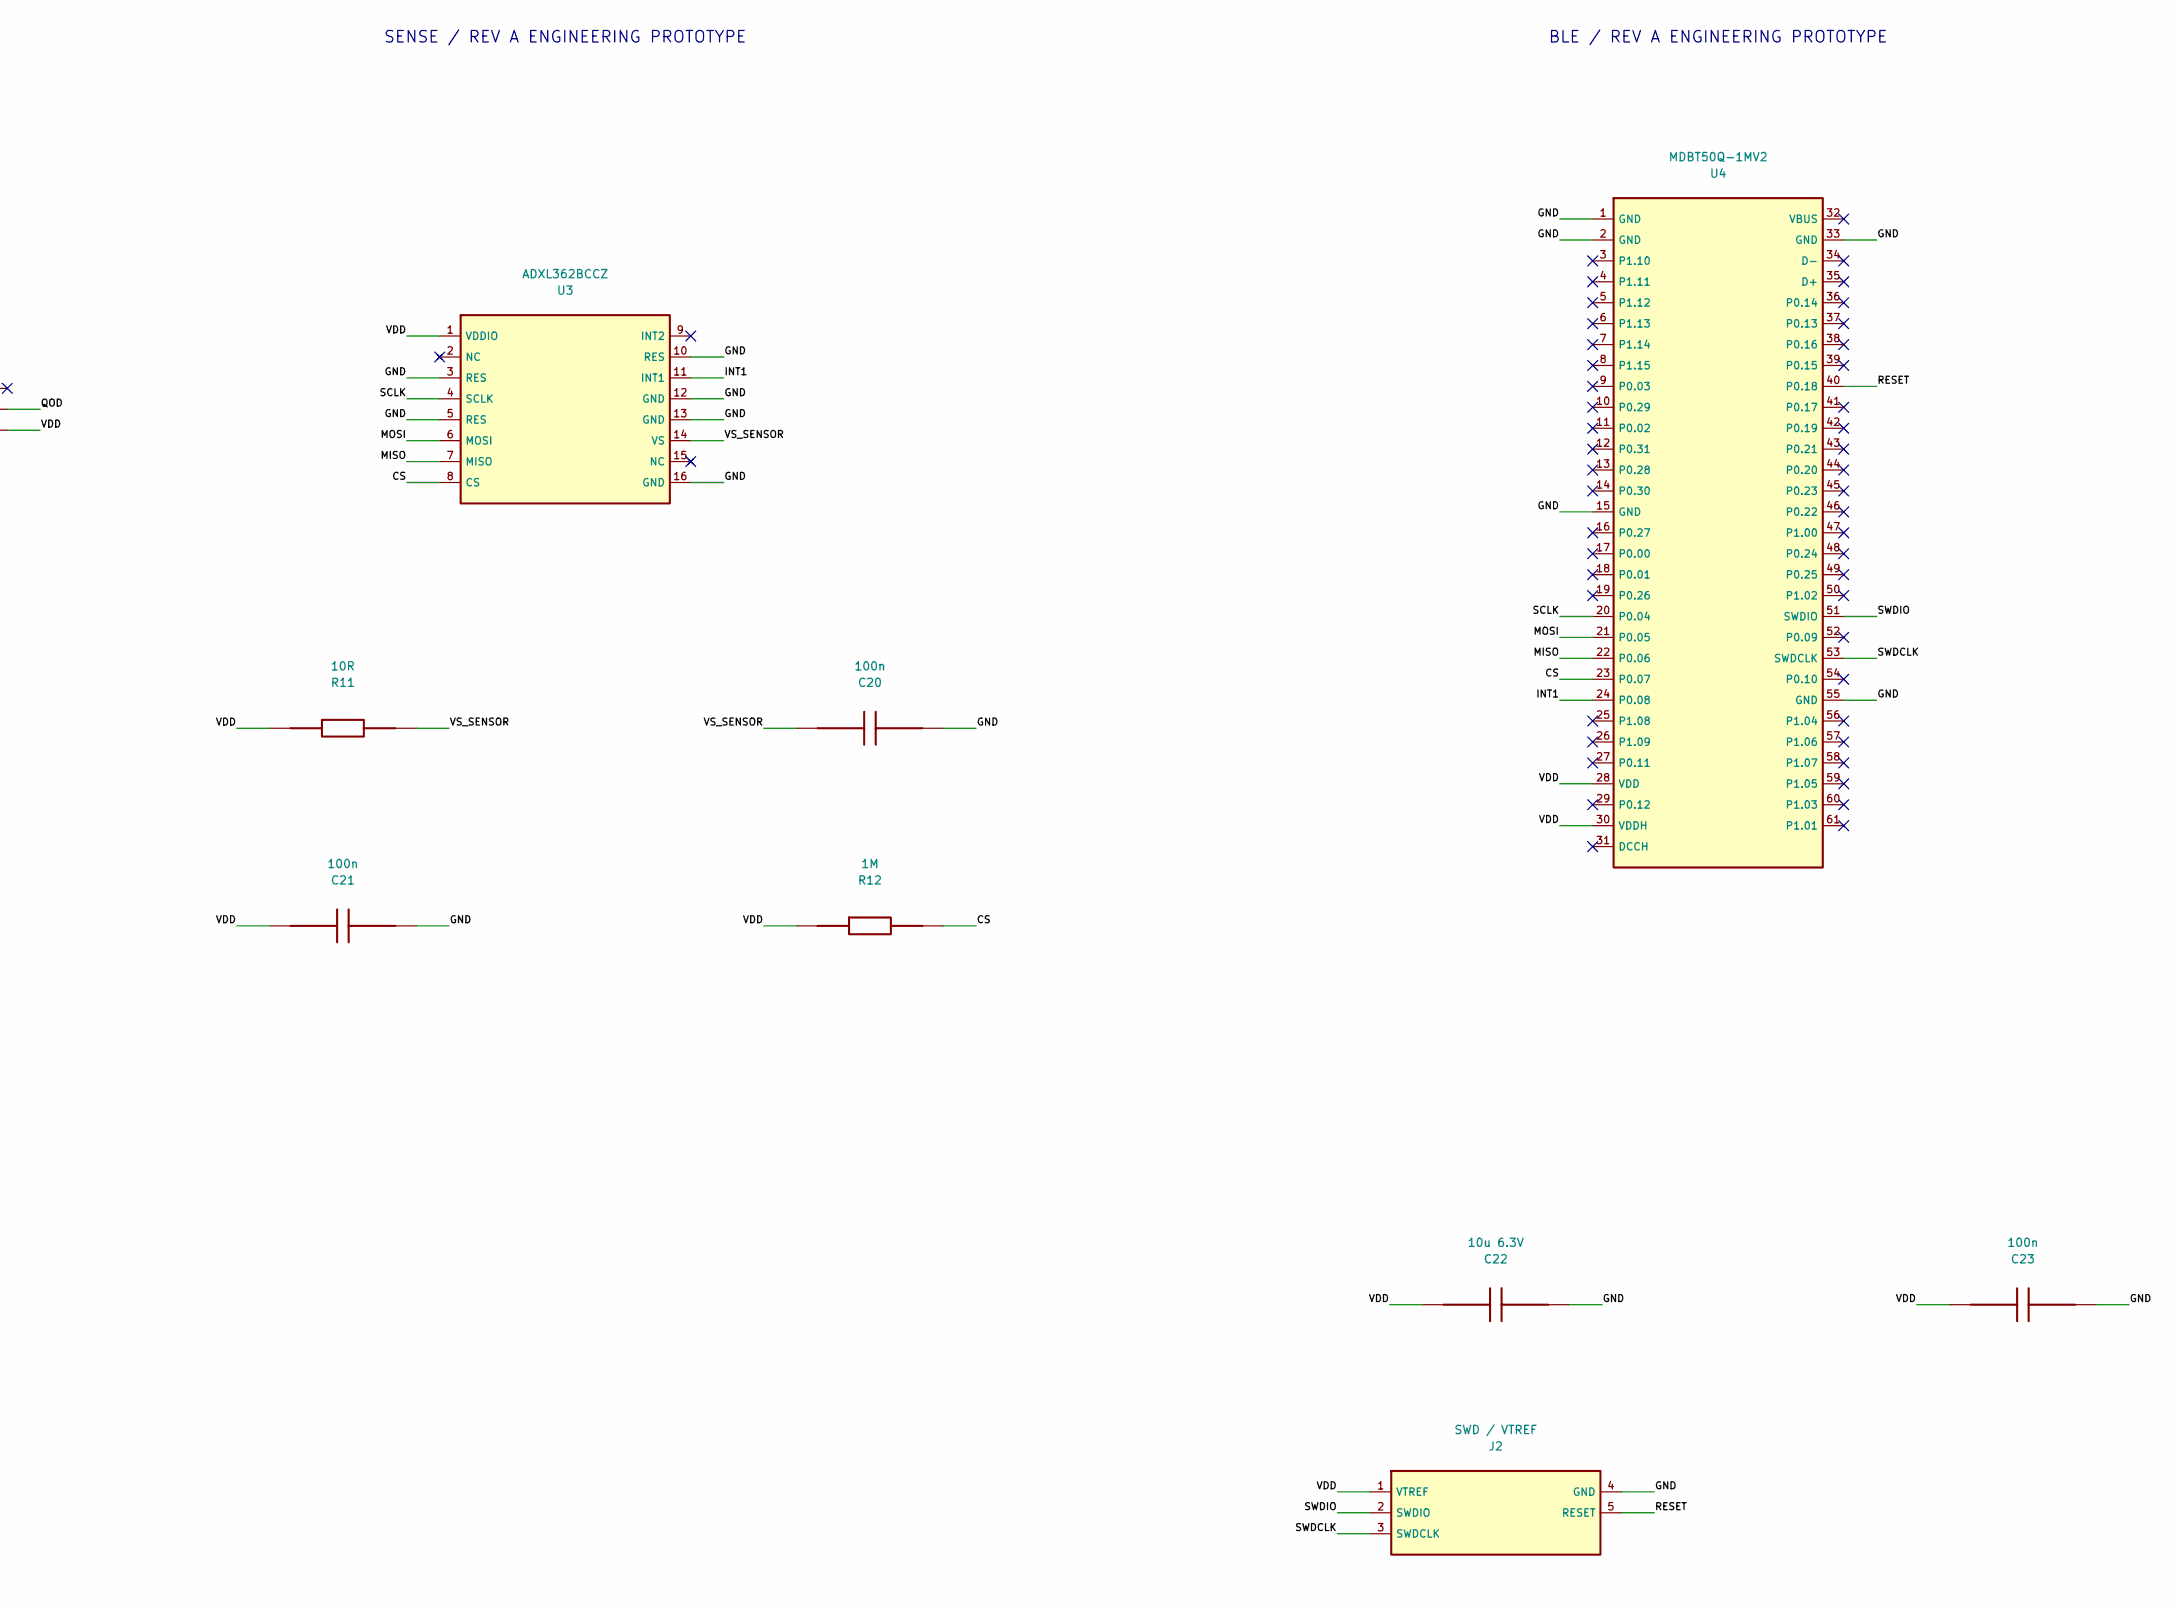
[picture p30: schematic amp_sensor.kicad_sch, part in row 1, column 2]

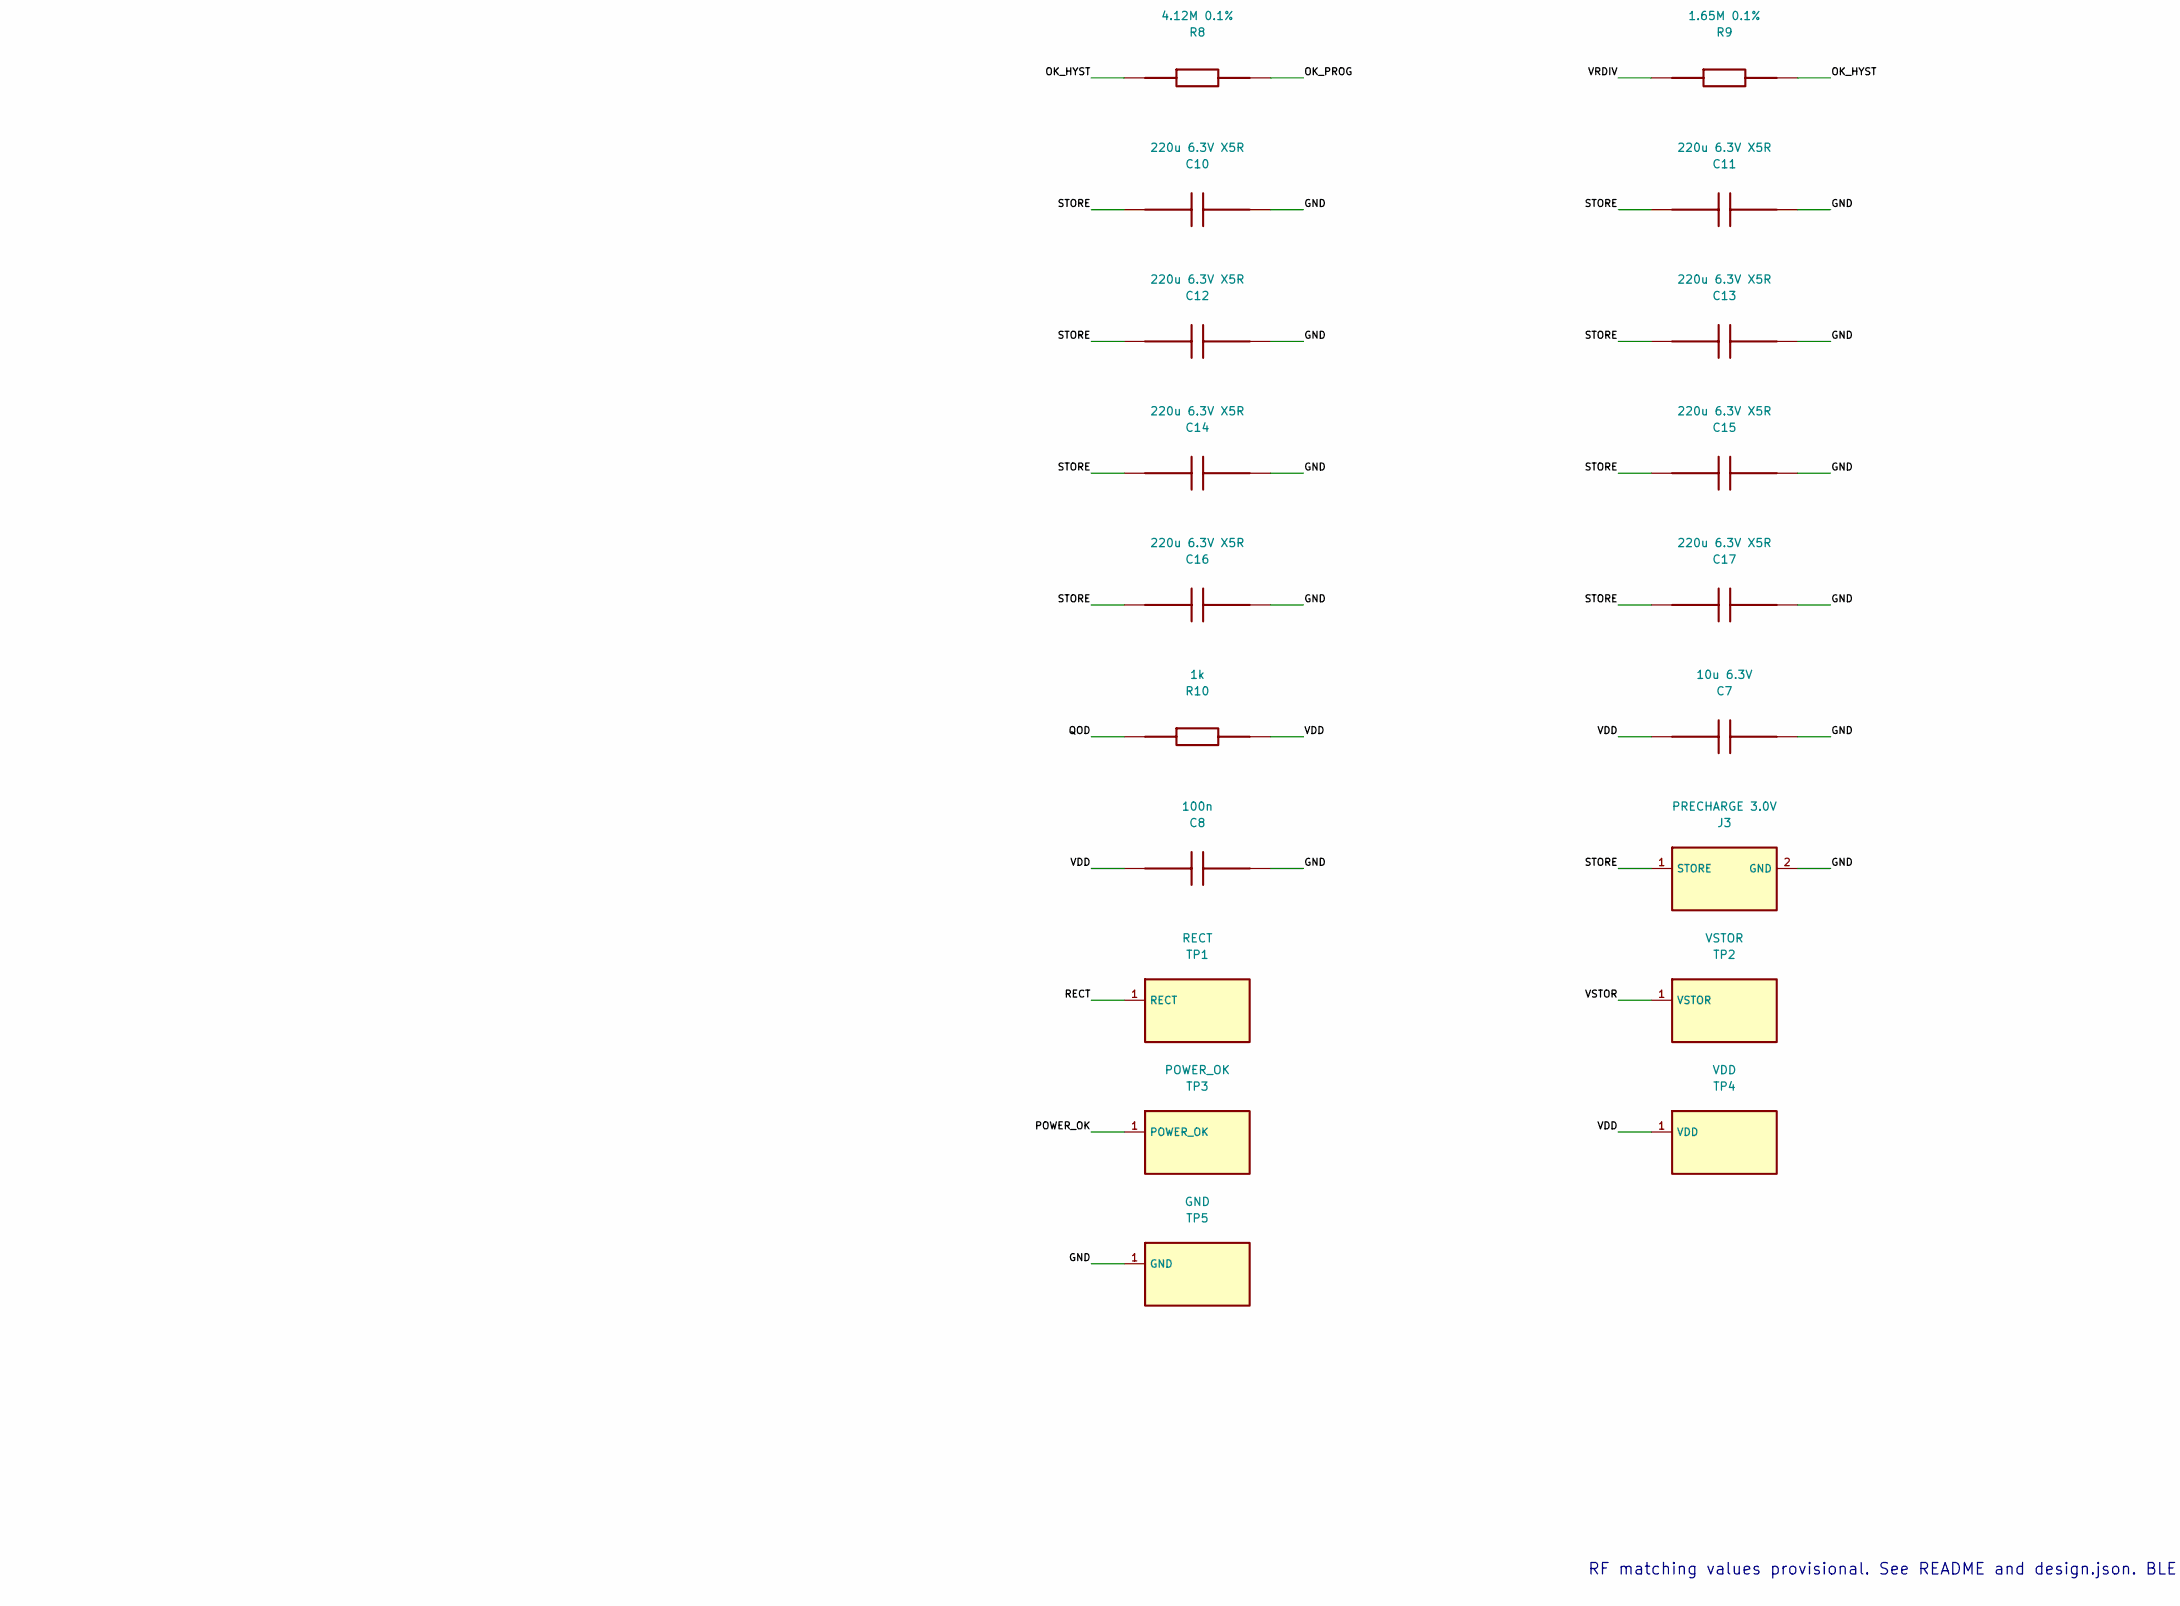
[picture p31: schematic amp_sensor.kicad_sch, part in row 2, column 1]

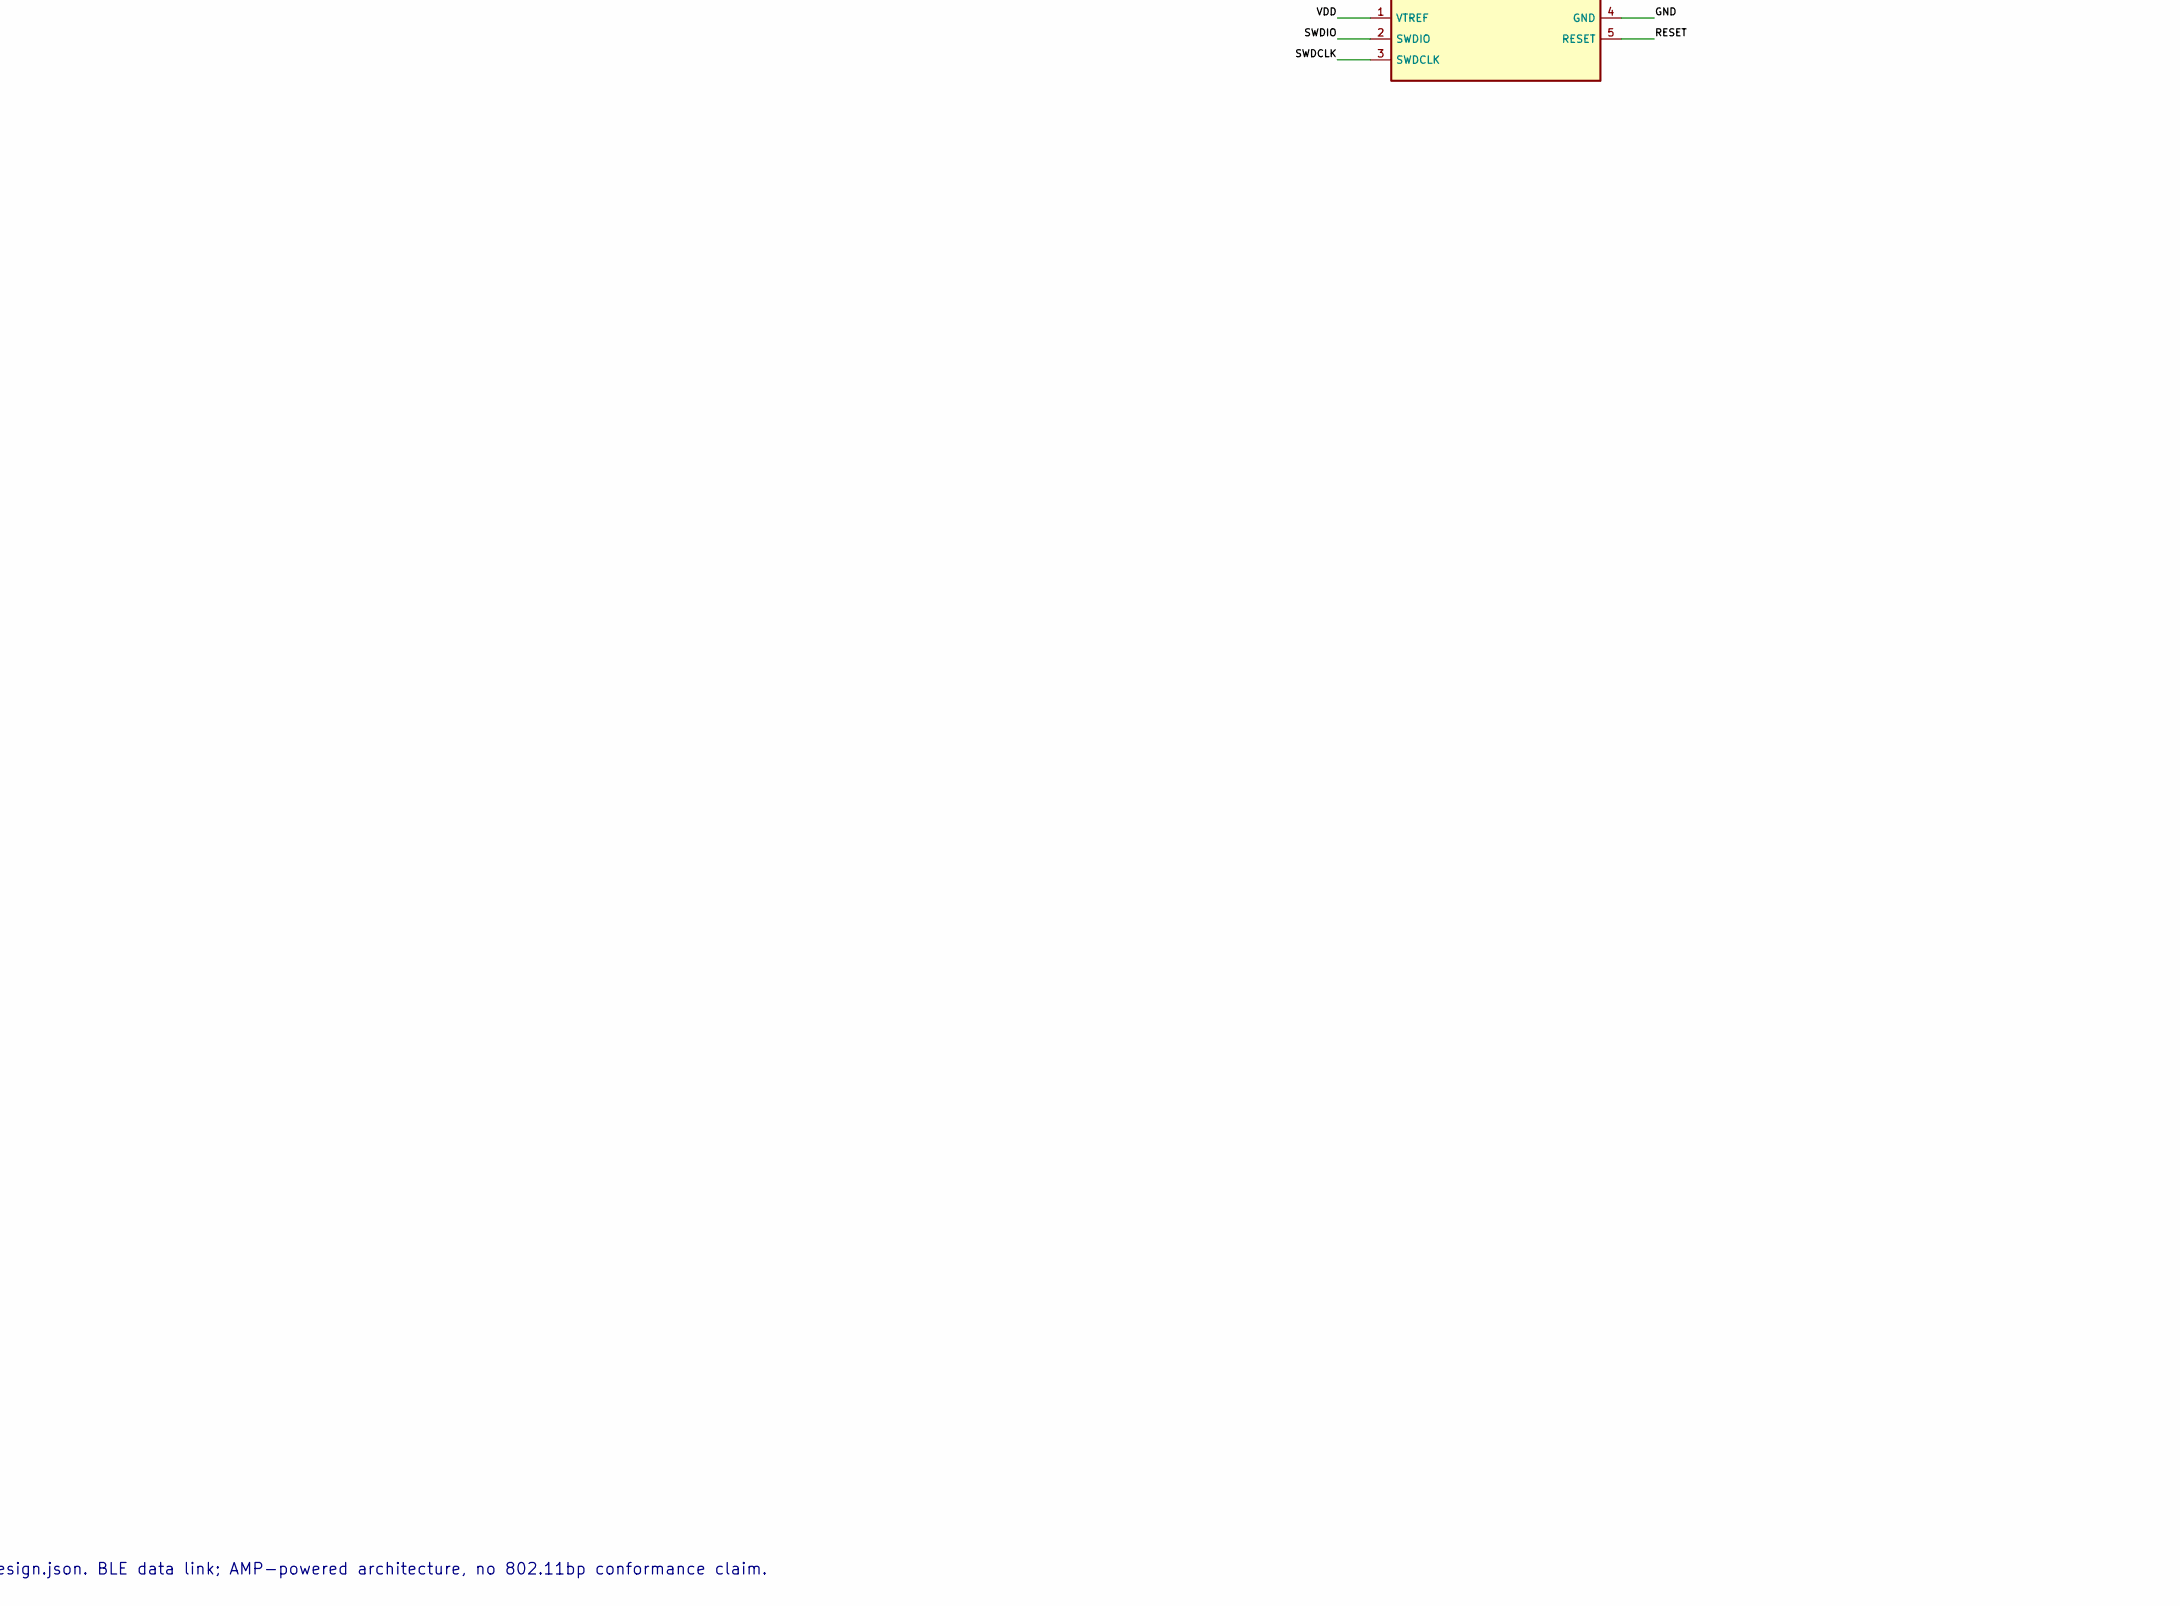
[picture p32: schematic amp_sensor.kicad_sch, part in row 2, column 2]

Parts:
C1: DNP tune; C_0603_1608Metric
C2, C3: 100p C0G; C_0603_1608Metric
C4, C5: 4.7u 10V; C_0603_1608Metric
C6: 10n C0G; C_0603_1608Metric
C7, C22: 10u 6.3V; C_0603_1608Metric
C8, C20, C21, C23: 100n; C_0603_1608Metric
C10, C11, C12, C13, C14, C15, C16, C17: 220u 6.3V X5R; C_1210_3225Metric
D1, D2: SMS7630-079LF; SC79
J1: RF_IN; U.FL_Hirose_U.FL-R-SMT-1_Vertical
J2: SWD / VTREF; PinHeader_1x05_P2.54mm_Vertical
J3: PRECHARGE 3.0V; PinHeader_1x02_P2.54mm_Vertical
L1: 10n tune / 2450MHz; L_0603_1608Metric
L2: 22u Isat>=300mA; L_Taiyo-Yuden_NR-40xx
R1, R2: 10M; R_0603_1608Metric
R3, R5: 5.62M 0.1%; R_0603_1608Metric
R4: 4.22M 0.1%; R_0603_1608Metric
R6: 4.42M 0.1%; R_0603_1608Metric
R7, R8: 4.12M 0.1%; R_0603_1608Metric
R9: 1.65M 0.1%; R_0603_1608Metric
R10: 1k; R_0603_1608Metric
R11: 10R; R_0603_1608Metric
R12: 1M; R_0603_1608Metric
TP1: RECT; TestPoint_Pad_D1.0mm
TP2: VSTOR; TestPoint_Pad_D1.0mm
TP3: POWER_OK; TestPoint_Pad_D1.0mm
TP4: VDD; TestPoint_Pad_D1.0mm
TP5: GND; TestPoint_Pad_D1.0mm
U1: BQ25504; VQFN-16-1EP_3x3mm_P0.5mm_EP1.68x1.68mm
U2: TPS22917DBV; SOT-23-6
U3: ADXL362BCCZ; Analog_LGA-16_3.25x3mm_P0.5mm_LayoutBorder3x5y
U4: MDBT50Q-1MV2; Raytac_MDBT50Q

Connections:
CS: R12.2, U3.8 (CS), U4.23 (P0.07)
GND: C1.2, C3.2, C4.2, C5.2, C6.2, C7.2, C8.2, C10.2, C11.2, C12.2, C13.2, C14.2, C15.2, C16.2, C17.2, C20.2, C21.2, C22.2, C23.2, D1.1 (A), J1.2 (GND), J2.4 (GND), J3.2 (GND), R2.2, R3.2, R5.2, R7.2, TP5.1, U1.1 (VSS), U1.5 (OT_PROG), U1.12 (AVSS), U1.13 (VSS), U1.17 (PAD), U2.2 (GND), U3.3 (RES), U3.5 (RES), U3.10 (RES), U3.12 (GND), U3.13 (GND), U3.16 (GND), U4.1 (GND), U4.2 (GND), U4.15 (GND), U4.33 (GND), U4.55 (GND)
INT1: U3.11 (INT1), U4.24 (P0.08)
MISO: U3.7 (MISO), U4.22 (P0.06)
MOSI: U3.6 (MOSI), U4.21 (P0.05)
MPPT: R1.2, R2.1, U1.3 (VOC_SAMP)
OK_HYST: R8.1, R9.2, U1.9 (OK_HYST)
OK_PROG: R7.1, R8.2, U1.10 (OK_PROG)
OV: R3.1, R4.2, U1.6 (VBAT_OV)
POWER_OK: TP3.1, U1.11 (VBAT_OK), U2.3 (ON)
PUMP: C2.2, D1.2 (K), D2.1 (A)
QOD: R10.1, U2.5 (QOD)
RECT: C3.1, C4.1, D2.2 (K), L2.1, R1.1, TP1.1, U1.2 (VIN_DC)
RESET: J2.5 (RESET), U4.40 (P0.18)
RF_IN: C1.1, J1.1 (RF), L1.1
RF_MATCH: C2.1, L1.2
SCLK: U3.4 (SCLK), U4.20 (P0.04)
STORE: C10.1, C11.1, C12.1, C13.1, C14.1, C15.1, C16.1, C17.1, J3.1 (STORE), U1.14 (VBAT)
SW: L2.2, U1.16 (LBST)
SWDCLK: J2.3 (SWDCLK), U4.53 (SWDCLK)
SWDIO: J2.2 (SWDIO), U4.51 (SWDIO)
UV: R5.1, R6.2, U1.8 (VBAT_UV)
VDD: C7.1, C8.1, C21.1, C22.1, C23.1, J2.1 (VTREF), R10.2, R11.1, R12.1, TP4.1, U2.6 (VOUT), U3.1 (VDDIO), U4.28 (VDD), U4.30 (VDDH)
VRDIV: R4.1, R6.1, R9.1, U1.7 (VRDIV)
VREF: C6.1, U1.4 (VREF_SAMP)
VSTOR: C5.1, TP2.1, U1.15 (VSTOR), U2.1 (VIN)
VS_SENSOR: C20.1, R11.2, U3.14 (VS)

Notes on the sheet:
RF / REV A ENGINEERING PROTOTYPE
POWER / REV A ENGINEERING PROTOTYPE
SENSE / REV A ENGINEERING PROTOTYPE
BLE / REV A ENGINEERING PROTOTYPE
RF matching values provisional. See README and design.json. BLE data link; AMP-powered architecture, no 802.11bp conformance claim.

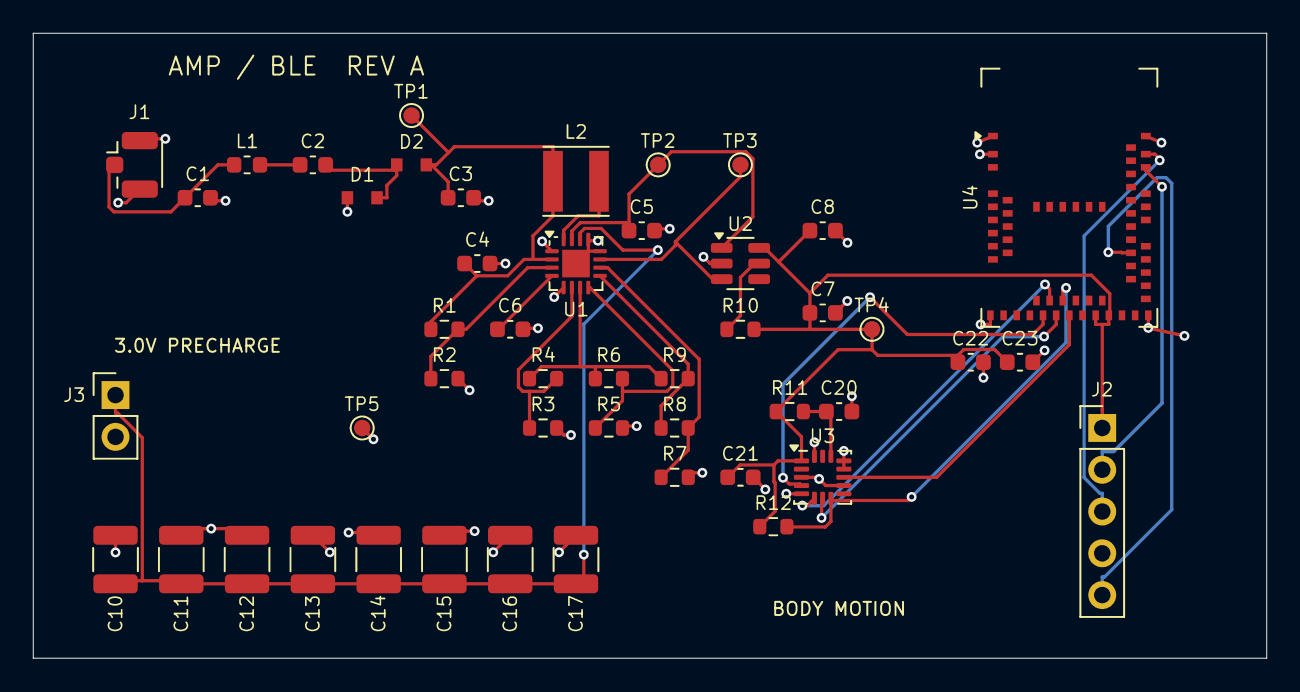
[picture p33: board amp_sensor.kicad_pcb from above]

Board: 2 copper layers, 75.0 x 38.0 mm, 48 parts (0 on the bottom side), 27 nets.
