kglnsk/amp-power-whitepaper/(commit log)

2026-11-11 Publish illustrated AMP white paper and downloadable engineering results
    [amp_sensor.kicad_pcb, amp_sensor.kicad_sch, antenna_2450.kicad_pcb, antenna_868_fr4.kicad_pcb, antenna_915_hypothesis.kicad_pcb, bom.csv, budget.csv, budget_868.csv]
2026-11-11 Add interactive board models and combined copper layers
2026-11-11 Fix viewer sizing and hide print image despite stale browser CSS
